Jason-sketch729/OpenSourcePlanarCableRobot-main/CableRobotFinalVersion.jpg

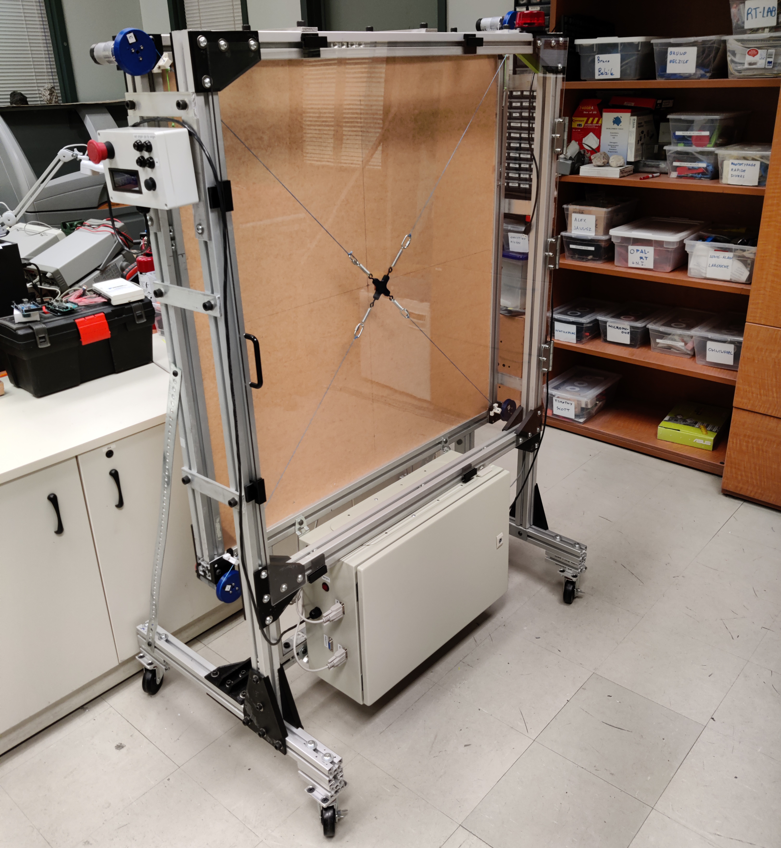
CableRobotFinalVersion.jpg
