Jason-sketch729/OpenSourcePlanarCableRobot-main/BOM.xlsx

PLANAR CDPR BILL OF MATERIALS
Designation | Manufacturer / Supplier | QTY | Unit | Unit Price | Total | Link / Comment
MECHANICAL STRUCTURE
Aluminum extrusions 45mm | Bosh-Rexroth | 14.1 | m | $35.36 | $498.55 | https://store.boschrexroth.com/Assembly-Technology/Basic-mechanic-elements/Profiles-and-accessories/Strut-profile/STRUT-PROFILE_3842553621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
Aluminum bars 3/8" x 1.5" | Hardware store | 1.6 | m | $26.00 | $41.60 | N/A
ABS for 3D printed parts | Amazon | 3.6 | kg | $22.87 | $82.35 | https://www.amazon.ca/AMZ3D-1-75mm-Black-Printer-Filament/dp/B01D999TVO
Caster wheels | Amazon | 4 |  | $6.05 | $24.19 | https://www.amazon.com/GBL-Casters-Castors-Furniture-Workbench/dp/B07KVM276F/
Polycarbonate Sheets: 1/8" (front) and 1/4" (back) thick, 1m square | Polyalto | 2 |  | $125.24 | $250.47 | https://www.polyalto.com/fr/catalogue/produits/polycarbonate-gp-tout-usage
Hinges | Amazon | 3 |  | $2.00 | $6.00 | https://www.amazon.com/Brushed-Interior-Corners-Residential-Hardware/dp/B09T3D2C62/
Springs box | Amazon | 1 |  | $12.01 | $12.01 | https://www.amazon.com/Neiko-50456A-Assortment-Compression-Extension/dp/B000K7M36W/
250lb cable | Amazon | 1 |  | $13.95 | $13.95 | https://www.amazon.com/emma-kites-Braided-Creative-Projects/dp/B01850OST0
Drop in T nuts | Aliexpress | 180 |  | $0.47 | $84.15 | https://www.aliexpress.com/item/4001249847405.html
M8 screws | Aliexpress | 180 |  | $0.31 | $55.44 | https://www.aliexpress.com/item/4000148454577.html
Door handle | Amazon | 1 |  | $6.50 | $6.50 | https://www.amazon.com/Uxcell-a11081400ux0074-Cabinet-Plastic-Rectangular/dp/B007VBT5CA/
Mini carabiner clip kit | Amazon | 1 |  | $8.99 | $8.99 | https://www.amazon.com/Stainless-Steel-Carabiner-Clip-Spring-Snap/dp/B08DTCM52N/
Eye hooks #3 kit | Aliexpress | 1 |  | $2.38 | $2.38 | https://www.aliexpress.com/item/1005002732256168.html
M3 screw kit | Amazon | 1 |  | $17.96 | $17.96 | https://www.amazon.com/VIGRUE-570PCS-Stainless-Assortment-Machine/dp/B08H24W42K/
ELECTRICAL HARDWARE
Panel mount usb connector | Amazon | 1 |  | $7.99 | $7.99 | https://www.amazon.com/ChenYang-Degree-Angled-Female-extension/dp/B00S5WJ5RO/
Electrical cabinet | Allied Electric | 1 |  | $103.46 | $103.46 | https://www.alliedelec.com/product/rs-pro-by-allied/7755328/70824480/
Electrical box (teach pendant) | Digikey | 1 |  | $7.60 | $7.60 | https://www.digikey.com/en/products/detail/bud-industries/PT-11557-G/387082
Push buttons | Digikey | 4 |  | $2.01 | $8.04 | https://www.digikey.com/en/products/detail/e-switch/PS1023ABLK/82862
Potentiometer Joystick | Digikey | 1 |  | $4.50 | $4.50 | https://www.digikey.com/en/products/detail/sparkfun-electronics/COM-09032/
680 ohm resistor | Digikey | 8 |  | $0.10 | $0.80 | https://www.digikey.com/en/products/detail/yageo/CFR-25JT-52-680R/9098651
1 kohm resistor | Digikey | 1 |  | $0.10 | $0.10 | https://www.digikey.com/en/products/detail/yageo/CFR-25JB-52-1K/96
100 nF capacitor | Digikey | 8 |  | $0.33 | $2.64 | https://www.digikey.com/en/products/detail/kemet/C320C104K3R5TA/12701287
22mF 25V capacitor | Digikey | 1 |  | $4.87 | $4.87 | https://www.digikey.com/en/products/detail/nichicon/LLS1E223MELB
LCD screen | Adafruit | 1 |  | $17.95 | $17.95 | https://www.adafruit.com/product/198
Barrier Blocks 2 positions | Digikey | 4 |  | $2.59 | $10.36 | https://www.digikey.com/en/products/detail/te-connectivity-amp-connectors/1546477-2/2284035
Barrier Blocks 4 positions | Digikey | 2 |  | $2.94 | $5.88 | https://www.digikey.com/en/products/detail/te-connectivity-amp-connectors/1546306-4/1277415
General purpose prototype boards | Digikey | 5 |  | $1.59 | $7.95 | https://www.digikey.com/en/products/detail/chip-quik-inc/SBBTH1508-1/5978279
Crimp Connectors | Amazon | 1 |  | $39.99 | $39.99 | https://www.amazon.com/haisstronica-Crimping-Connectors-HS-8327-Electrical/dp/B099W4FVRB/
Straight pin header (0.1" pitch) | Robotshop | 5 |  | $1.61 | $8.05 | https://www.robotshop.com/products/sfe-straight-pin-headers
Power entry module (IEC 320) | Digikey | 1 |  | $1.20 | $1.20 | https://www.digikey.com/en/products/detail/adam-tech/IEC-C-1-150/9830624
DB9 2m cable | Digikey | 4 |  | $5.20 | $20.80 | https://www.digikey.com/en/products/detail/cinch-connectivity-solutions/30-9506-99/3830292
DB-9 female connector | Digikey | 4 |  | $0.70 | $2.80 | https://www.digikey.com/en/products/detail/amphenol-cs-fci/DE09S064TLF/1001839
DB-9 male connector | Digikey | 4 |  | $0.72 | $2.88 | https://www.digikey.com/en/products/detail/amphenol-cs-fci/DE09P064TXLF/1001838
DB-15 | Digikey | 1 |  | $0.75 | $0.75 | https://www.digikey.com/en/products/detail/adam-tech/DA15-PR/9832244
D-sub backshells | Digikey | 4 |  | $0.78 | $3.12 | https://www.digikey.com/en/products/detail/assmann-wsw-components/AGP-09-G/1241839
Power switch on off with light | Digikey | 1 |  | $9.59 | $9.59 | https://www.digikey.com/en/products/detail/bulgin/H8553VBBA3-551W/2747894
Red Led | Digikey | 5 |  | $0.17 | $0.85 | https://www.digikey.com/en/products/detail/creeled-inc/C5SMF-RJF-CT0W0BB1/
CR2032 battery | Digikey | 1 |  | $0.48 | $0.48 | https://www.digikey.com/en/products/detail/murata-electronics/CR2032/9558425
12V Strobe Light | Amazon | 1 |  | $20.49 | $20.49 | https://www.amazon.com/12V-24V-Flashing-Magnetic-Straight-Forklift/dp/B07KF4HJ83/
Emergency Switch | Digikey | 1 |  | $57.77 | $57.77 | https://www.digikey.com/en/products/detail/omron-automation-and-safety/A22E-M-01/456041
Panduct wire duct | Allied Electric | 6 |  | $6.88 | $41.28 | https://www.alliedelec.com/product/panduit/f1x2lg6/70333454/
Power cord | Amazon | 1 |  | $6.75 | $6.75 | https://www.amazon.com/dp/B072BYGKZZ/
Nylon spacer kit | Amazon | 1 |  | $9.99 | $9.99 | https://www.amazon.com/Electrical-Spacers-Assortment-Threaded-Receptacle/dp/B0BKFYFXWR/
PG7 Cable Gland (10pcs) | Aliexpress | 1 |  | $1.17 | $1.17 | https://www.aliexpress.com/item/4000242432947.html
AWG 22 electrical wire (control signals) | Amazon | 1 |  | $16.98 | $16.98 | https://www.amazon.com/Silicone-Electrical-Conductor-Parallel-Flexible/dp/B07K9R9LBV/
AWG 18 electrical wire (motors) | Amazon | 1 |  | $12.98 | $12.98 | https://www.amazon.com/Silicone-Electrical-Conductor-Parallel-Flexible/dp/B07K9R9LBV/
MECHATRONIC ELEMENTS
DC Gearmotor 37Dx73L | Pololu | 4 |  | $51.95 | $207.80 | https://www.pololu.com/product/4755
L-Brackets | Pololu | 2 |  | $9.95 | $19.90 | https://www.pololu.com/product/1084
Universal Hubs | Pololu | 2 |  | $9.95 | $19.90 | https://www.pololu.com/product/1083
Current sensors ACS711EX | Pololu | 4 |  | $3.95 | $15.80 | https://www.pololu.com/product/2452
12V power supply | Digikey | 1 |  | $41.27 | $41.27 | https://www.digikey.com/en/products/detail/mean-well-usa-inc/LRS-350-12/7705030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
Roboclaw solo 30A | BasicMicro | 4 |  | $89.95 | $359.80 | https://www.basicmicro.com/Roboclaw-Solo-30A-34VDC-Motor-Controller_p_44.html
Arduino Mega | Robotshop | 1 |  | $48.40 | $48.40 | https://www.robotshop.com/products/arduino-mega-2560-microcontroller-rev3
Arduino pro mini | Robotshop | 1 |  | $10.95 | $10.95 | https://www.robotshop.com/products/arduino-pro-mini-328-5v-16mhz
VINT Hub (optional) | Phidgets | 1 |  | $30.00 | $30.00 | https://www.phidgets.com/?tier=3&catid=2&pcid=1&prodid=1202
MISC
Labels for the wiring | Amazon | 1 |  | $7.59 | $7.59 | https://www.amazon.com/Mr-Label-Inkjet-Printer-Support-Waterproof/dp/B01HB59G7O/
GRAND TOTAL |  |  |  |  | $2306.01
 |  |  |  |  | All prices exclude VAT, custom duties, and shipping
TOOL LIST
Screwdrivers
Drill with various size meshes
Soldering iron and tin
Miter saw (capable of aluminium cutting)
Allen keys
Electric tape
Heat shrink tubing
Crimping tool (if suggested connector kit not purchased)
Multimeter (optional, debugging)
Oscilloscope (optional, debugging)
Label maker (optional but strongly recommended)
AUTHORS
by Mikael Arslan and Lionel Birglen
Polytechnique Montreal
created: 2023-02-17
last update: 2023-06-22
Rev 1.02
