Jason-sketch729/OpenSourcePlanarCableRobot-main/CAD/SpiralPulley/Assembly.SLDASM

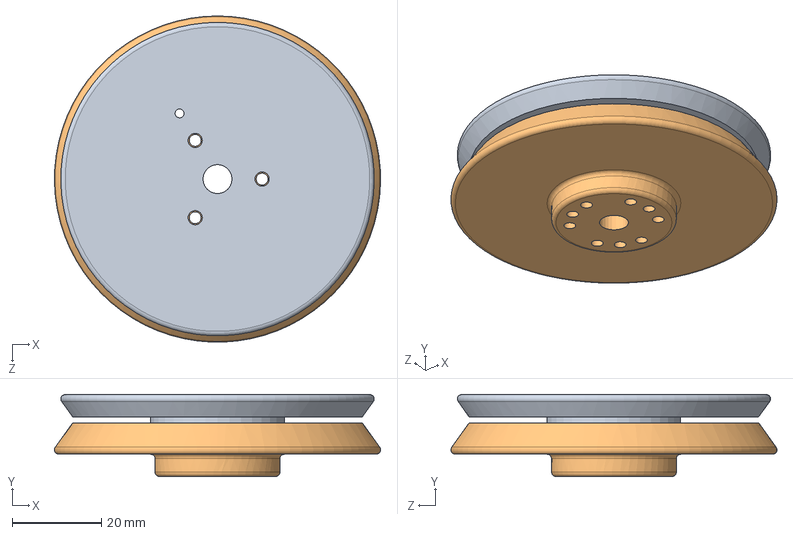
[picture p2: CAD file, 2019-04-16]
CAD/SpiralPulley/Assembly.SLDASM
73.1 x 18.4 x 73.1 mm
partB
partA
