Jason-sketch729/OpenSourcePlanarCableRobot-main/CAD/RobotMainFrame/ActuationUnit.SLDASM

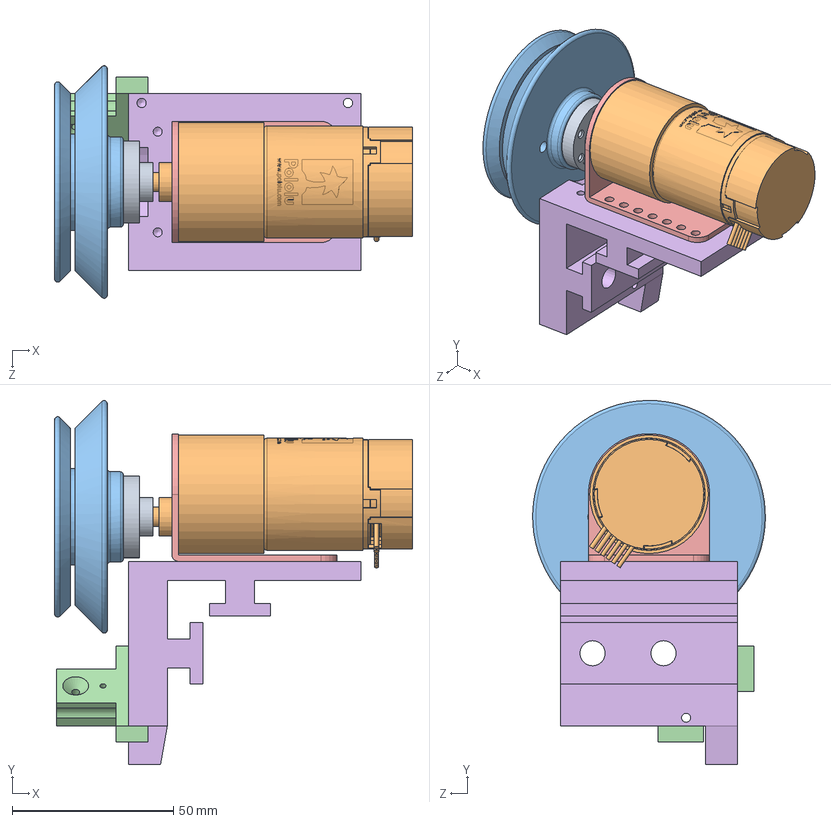
[picture p3: CAD file, 2019-04-07]
CAD/RobotMainFrame/ActuationUnit.SLDASM
111.0 x 112.9 x 72.1 mm
coupleur_poulie-moteur
moteur
poulie_originale
redirecteur
support_moteur
support_moteur_extrusion
