Jason-sketch729/OpenSourcePlanarCableRobot-main/CAD/RobotMainFrame/CableRobotMainFrame.SLDASM

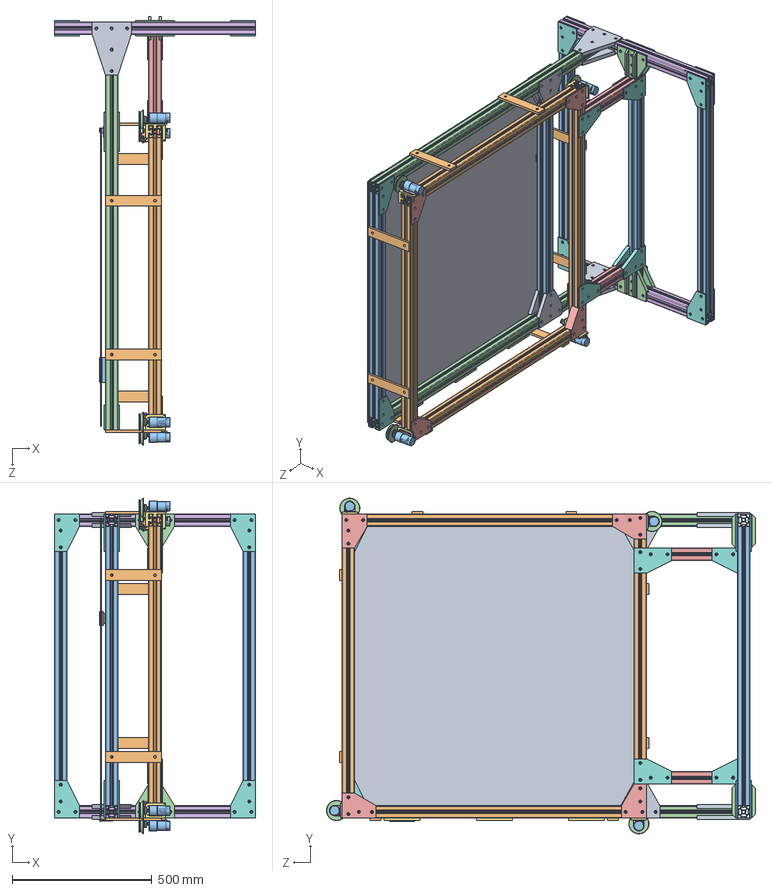
[picture p4: CAD file, 2019-04-07]
CAD/RobotMainFrame/CableRobotMainFrame.SLDASM
720.0 x 1201.8 x 1535.9 mm
extrusion_alu_45_1045 x 4
extrusion_alu_45_1000 x 5
extrusion_alu_45_1415 x 2
extrusion_alu_45_325 x 2
extrusion_alu_45_720 x 2
cale_charnière x 3
equerre_L_support_angle x 10
equerre_T_support_inferieur x 4
plexi-protection
coupleur_poulie-moteur x 4
moteur x 4
poulie_originale x 4
redirecteur x 4
support_moteur x 4
support_moteur_extrusion x 4
equerre_L_support_angle_sym x 10
equerre_T_support_milieu x 4
barre_alu x 8
demi_charnière_porte_3.5in x 2
equerre_T_support_base x 4
equerre_L_support_angle_arriere x 4
support_aimant_plexi
support aimant cadre
