Jason-sketch729/OpenSourcePlanarCableRobot-main/CAD/ElectricalCabinet/3DPrintedParts/standoff.STL

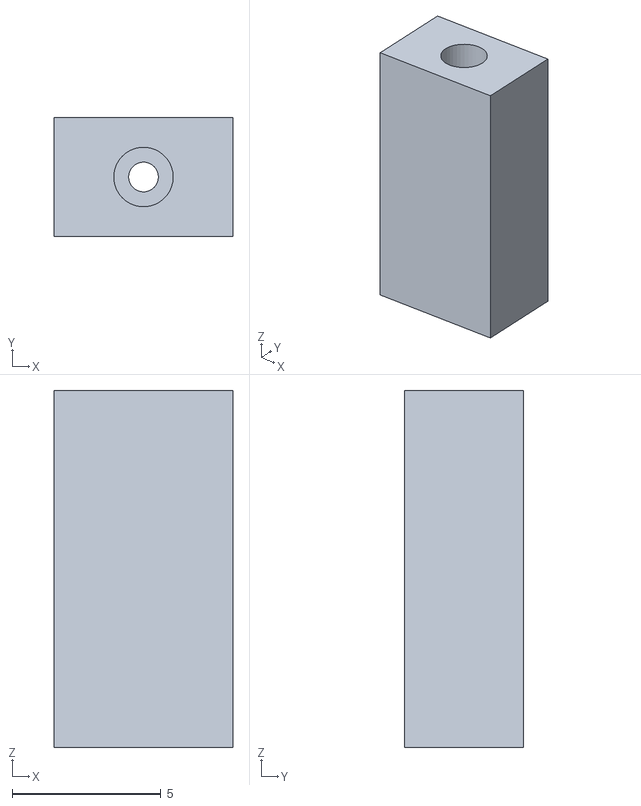
[picture p5: CAD file, 2019-04-02]
CAD/ElectricalCabinet/3DPrintedParts/standoff.STL
6.00 x 4.00 x 12.0
