Jason-sketch729/OpenSourcePlanarCableRobot-main/CAD/ElectricalCabinet/round_switch.SLDPRT

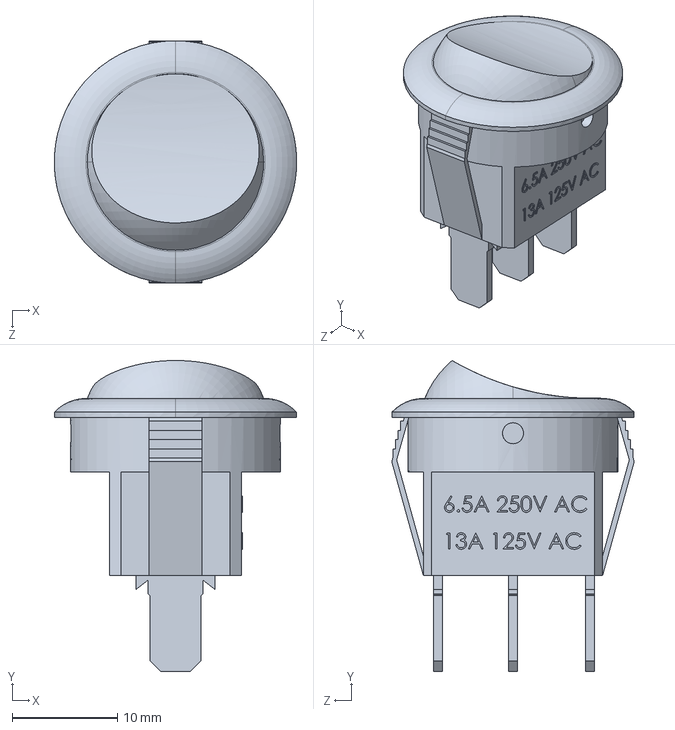
[picture p6: CAD file, 2019-04-03]
CAD/ElectricalCabinet/round_switch.SLDPRT
23.0 x 29.5 x 23.0 mm
