Jason-sketch729/OpenSourcePlanarCableRobot-main/CAD/RobotMainFrame/3DPrintedParts/support aimant cadre_0.STL

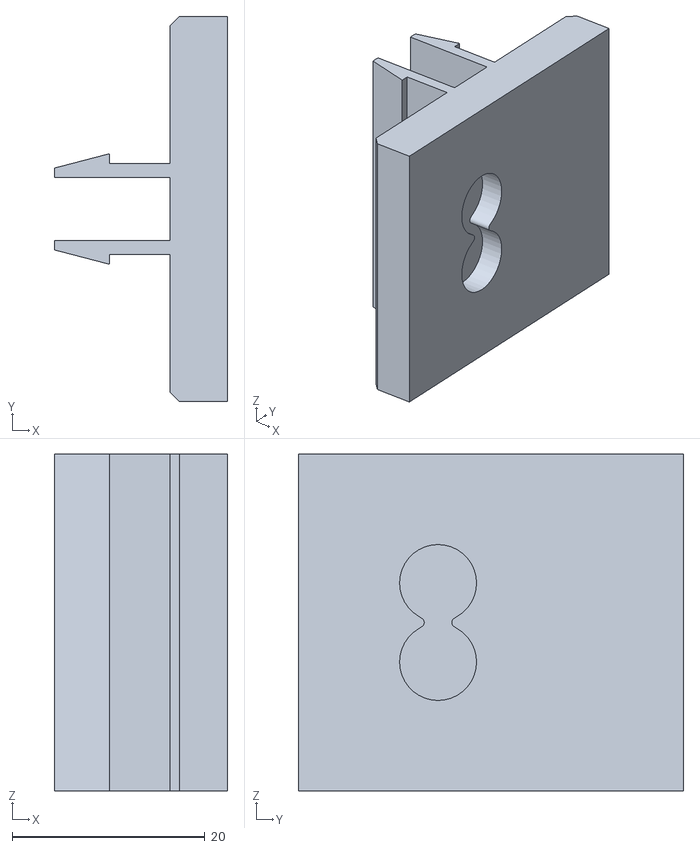
[picture p7: CAD file, 2019-04-07]
CAD/RobotMainFrame/3DPrintedParts/support aimant cadre_0.STL
18.0 x 40.0 x 35.0
