Jason-sketch729/OpenSourcePlanarCableRobot-main/CAD/RobotMainFrame/extrusions/extrusion_alu_45_720.SLDPRT

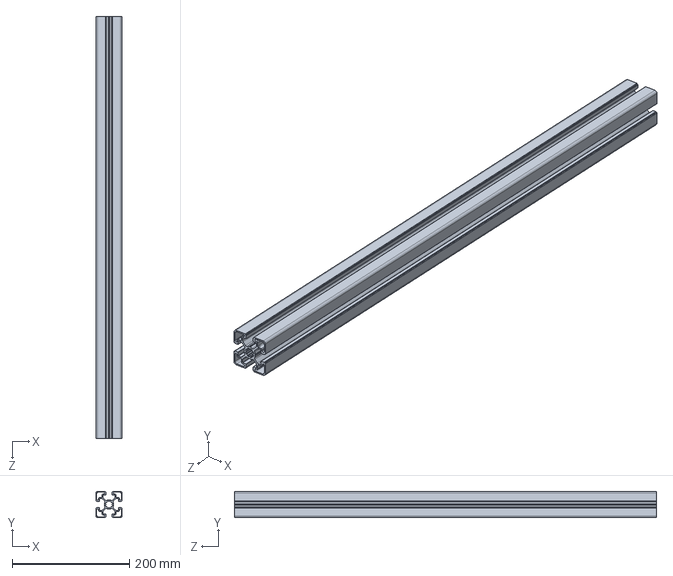
[picture p8: CAD file, 2019-04-08]
CAD/RobotMainFrame/extrusions/extrusion_alu_45_720.SLDPRT
45.0 x 45.0 x 720.0 mm
