Jason-sketch729/OpenSourcePlanarCableRobot-main/CAD/RobotMainFrame/pieces_bloc_moteur/support_moteur.SLDPRT

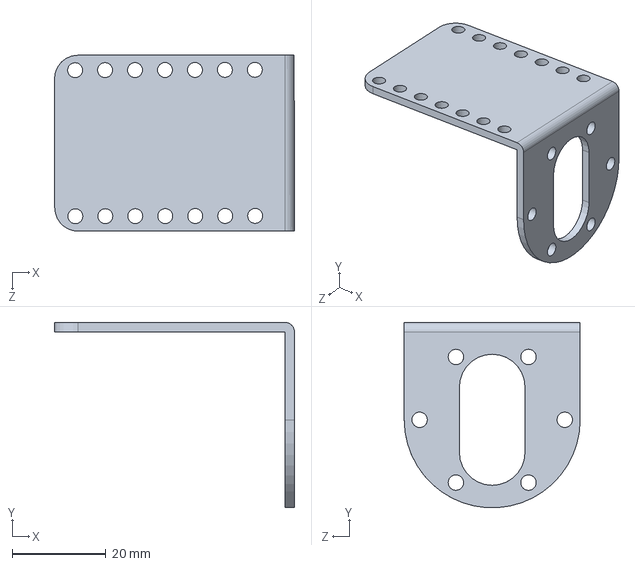
[picture p9: CAD file, 2019-04-08]
CAD/RobotMainFrame/pieces_bloc_moteur/support_moteur.SLDPRT
51.3 x 39.6 x 37.7 mm
