Jason-sketch729/OpenSourcePlanarCableRobot-main/CAD/RobotMainFrame/pieces_imprimes/cale_charnière.SLDPRT

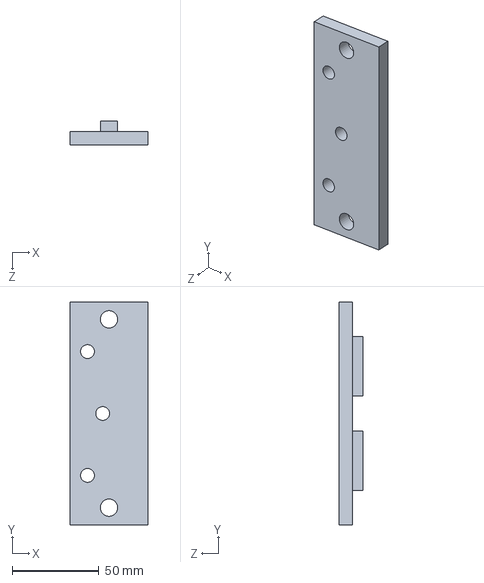
[picture p10: CAD file, 2019-04-15]
CAD/RobotMainFrame/pieces_imprimes/cale_charnière.SLDPRT
45.0 x 128.6 x 14.0 mm
