Jason-sketch729/OpenSourcePlanarCableRobot-main/CAD/RobotMainFrame/plexi-protection.SLDPRT

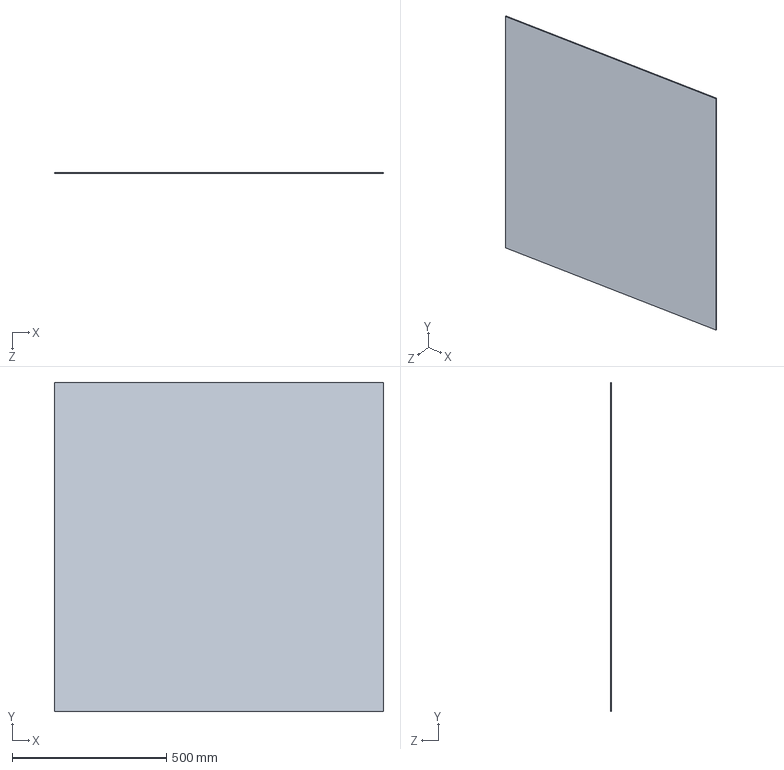
[picture p11: CAD file, 2019-04-16]
CAD/RobotMainFrame/plexi-protection.SLDPRT
1066.8 x 1066.8 x 4.76 mm
