Jason-sketch729/OpenSourcePlanarCableRobot-main/CAD/SpiralPulley/3DPrintedParts/partB.STL

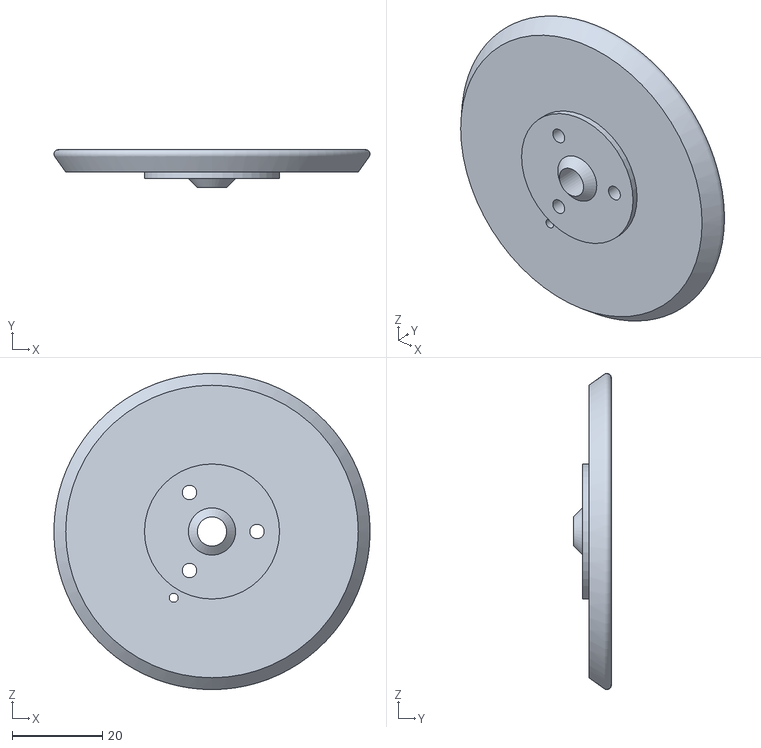
[picture p12: CAD file, 2019-04-16]
CAD/SpiralPulley/3DPrintedParts/partB.STL
70.2 x 8.40 x 70.3
