Jason-sketch729/OpenSourcePlanarCableRobot-main/RobotcableComplet.stp

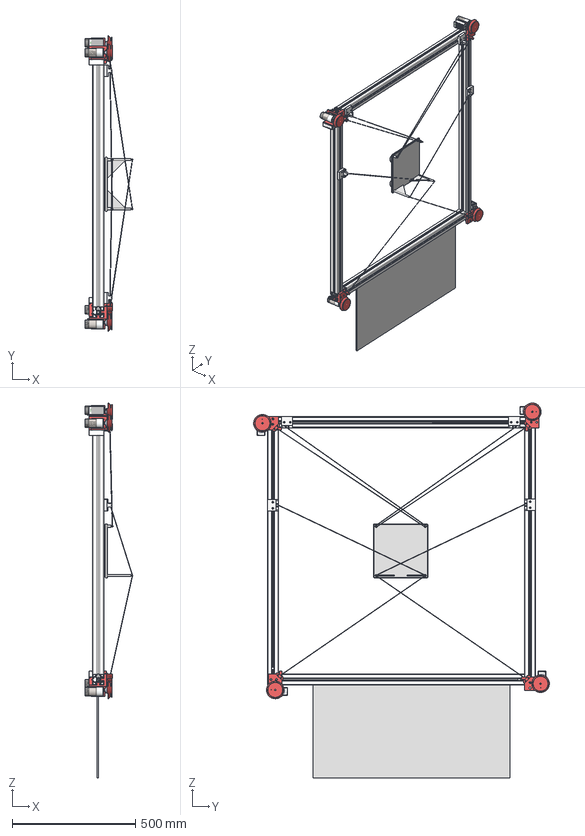
[picture p13: CAD file, 2019-04-22]
RobotcableComplet.stp
194.6 x 1201.7 x 1523.3 mm
Ross_Frame extrusion x 4
AttachmentModule x 4
Loop x 4
PF_Base
9496T350_ROUTING EYEBOLT FOR WOOD - NOT FOR LIFTING x 4
5674K100_FLANGE-MOUNT BALL TRANSFER x 4
37d-gearmotor-100-131-encoder x 4
pololu-universal-aluminum-mounting-hub-for-6mm-shaft-4-40-holes x 4
BracketPololu x 4
NewSpool x 4
MotorAttachmentV2_Pololu x 4
SupportRoboclaw x 4
MCSOLO_V2 x 4
NewRedirecteur x 4
SupportPlate
