Jason-sketch729/OpenSourcePlanarCableRobot-main/CAD/ElectricalCabinet/wire_duct_250.SLDPRT

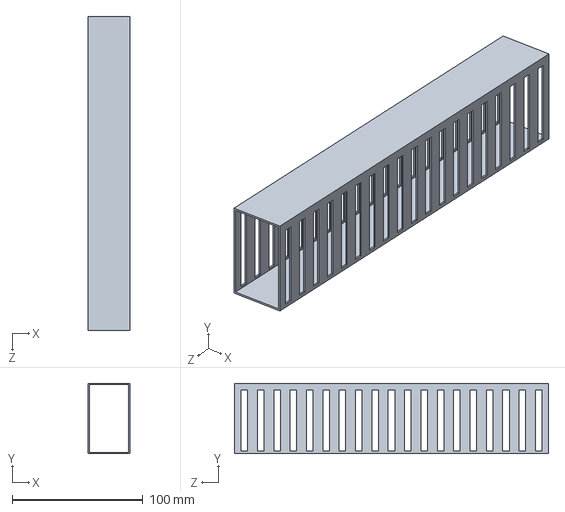
[picture p14: CAD file, 2019-04-03]
CAD/ElectricalCabinet/wire_duct_250.SLDPRT
32.0 x 53.8 x 240.0 mm
