Jason-sketch729/OpenSourcePlanarCableRobot-main/CAD/RobotMainFrame/3DPrintedParts/support_led_1.STL

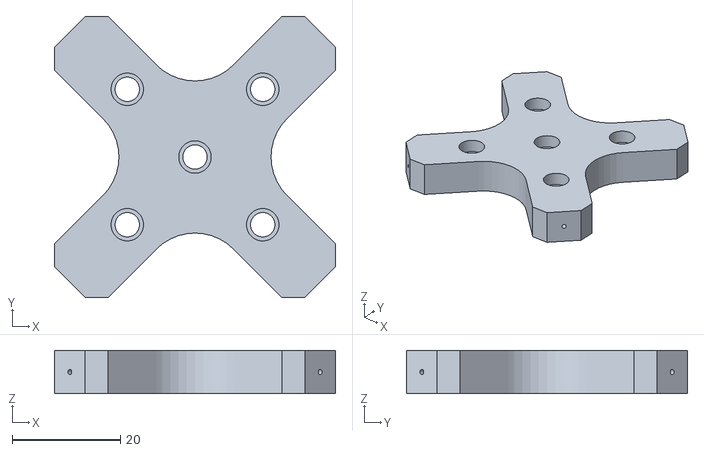
[picture p15: CAD file, 2019-04-07]
CAD/RobotMainFrame/3DPrintedParts/support_led_1.STL
51.9 x 51.9 x 8.00
