Jason-sketch729/OpenSourcePlanarCableRobot-main/CAD/RobotMainFrame/demi_charnière_porte_3.5in.SLDPRT

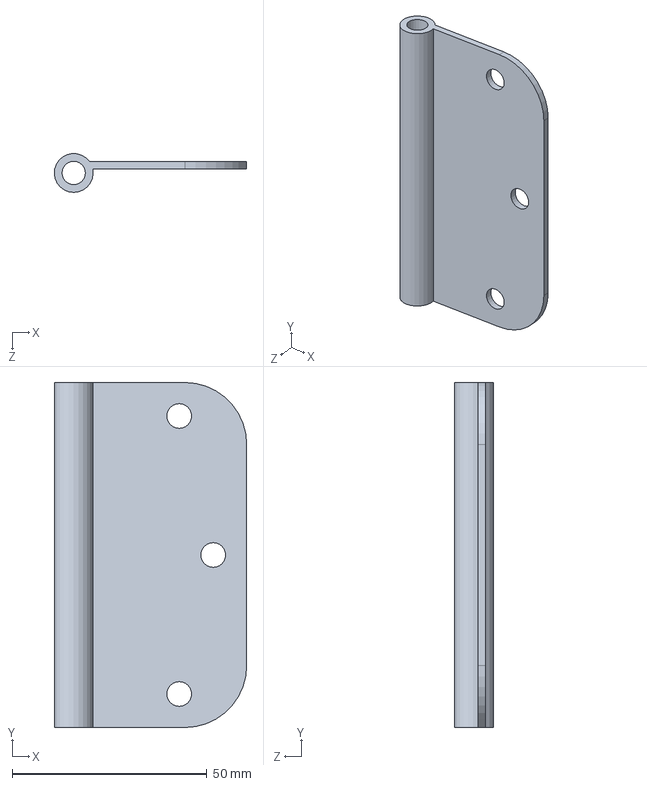
[picture p16: CAD file, 2019-04-07]
CAD/RobotMainFrame/demi_charnière_porte_3.5in.SLDPRT
49.4 x 88.6 x 9.98 mm
