Jason-sketch729/OpenSourcePlanarCableRobot-main/CAD/RobotMainFrame/extrusions/extrusion_alu_45_1415.SLDPRT

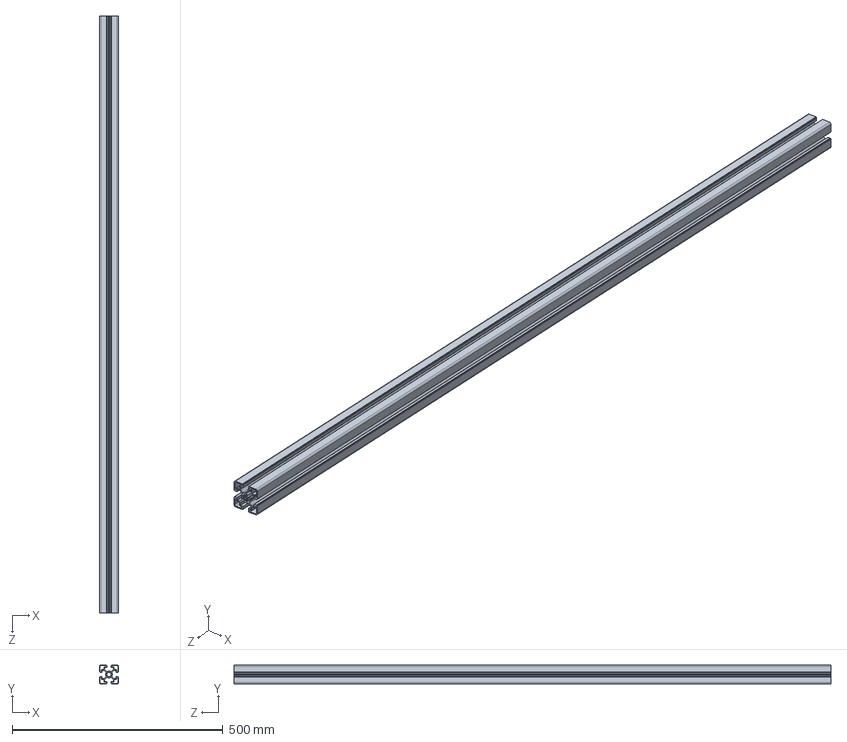
[picture p17: CAD file, 2019-04-08]
CAD/RobotMainFrame/extrusions/extrusion_alu_45_1415.SLDPRT
45.0 x 45.0 x 1415.0 mm
