Jason-sketch729/OpenSourcePlanarCableRobot-main/CAD/RobotMainFrame/pieces_bloc_moteur/coupleur_poulie-moteur.SLDPRT

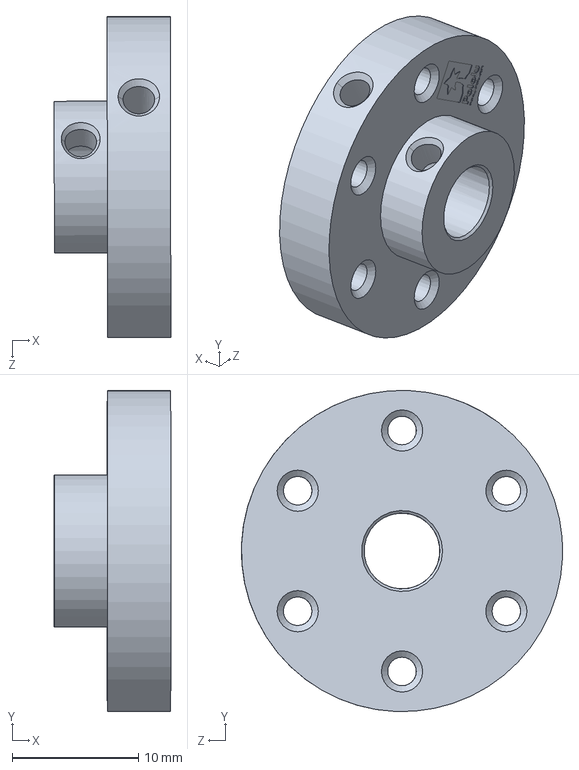
[picture p18: CAD file, 2019-04-08]
CAD/RobotMainFrame/pieces_bloc_moteur/coupleur_poulie-moteur.SLDPRT
9.24 x 25.4 x 25.4 mm
