Jason-sketch729/OpenSourcePlanarCableRobot-main/CAD/SpiralPulley/3DPrintedParts/partA.STL

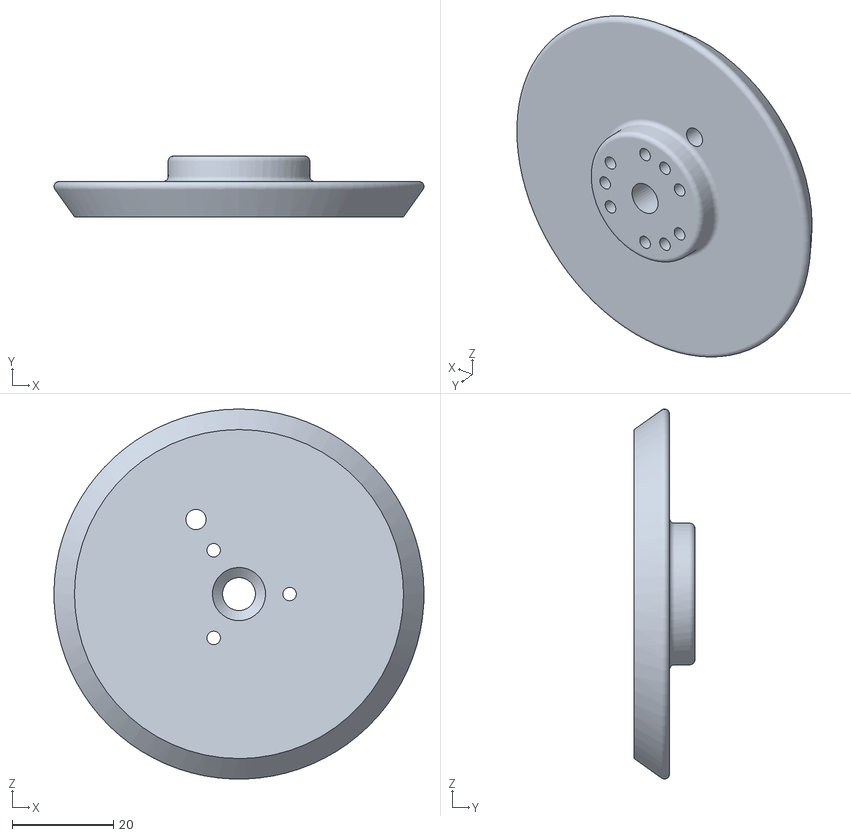
[picture p19: CAD file, 2019-04-16]
CAD/SpiralPulley/3DPrintedParts/partA.STL
73.1 x 12.0 x 73.1
