Jason-sketch729/OpenSourcePlanarCableRobot-main/CAD/ElectricalCabinet/mega_shield.SLDPRT

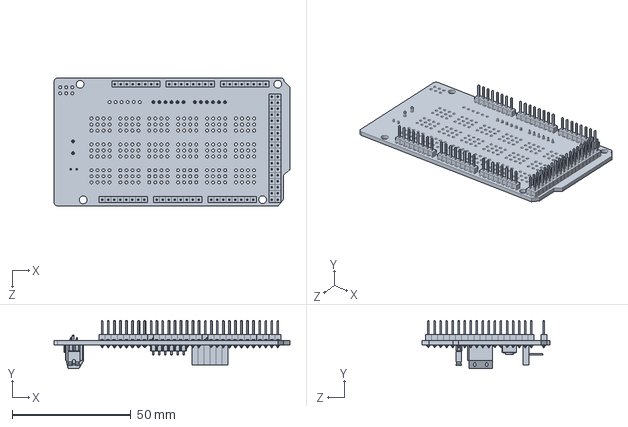
[picture p20: CAD file, 2019-04-03]
CAD/ElectricalCabinet/mega_shield.SLDPRT
99.2 x 20.3 x 53.7 mm
