Jason-sketch729/OpenSourcePlanarCableRobot-main/CAD/RobotMainFrame/3DPrintedParts/equerre_T_support_base_2.STL

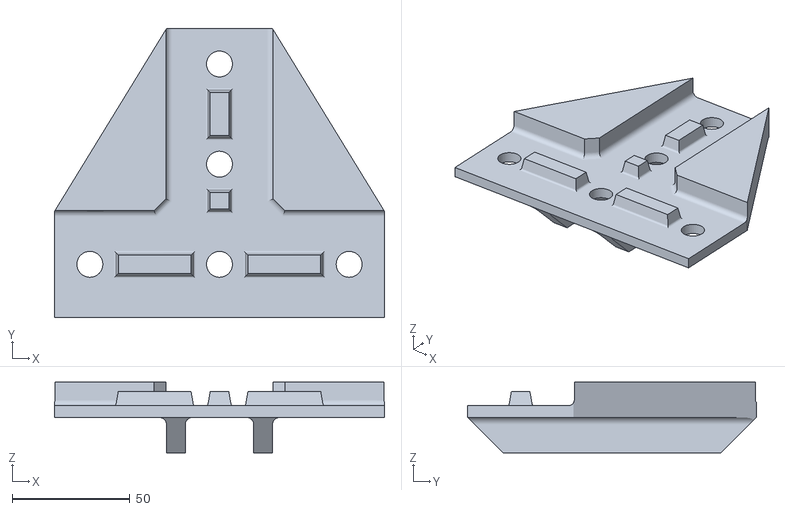
[picture p21: CAD file, 2019-04-07]
CAD/RobotMainFrame/3DPrintedParts/equerre_T_support_base_2.STL
140.0 x 122.5 x 30.0
