Jason-sketch729/OpenSourcePlanarCableRobot-main/CAD/RobotMainFrame/extrusions/extrusion_alu_45_1045.SLDPRT

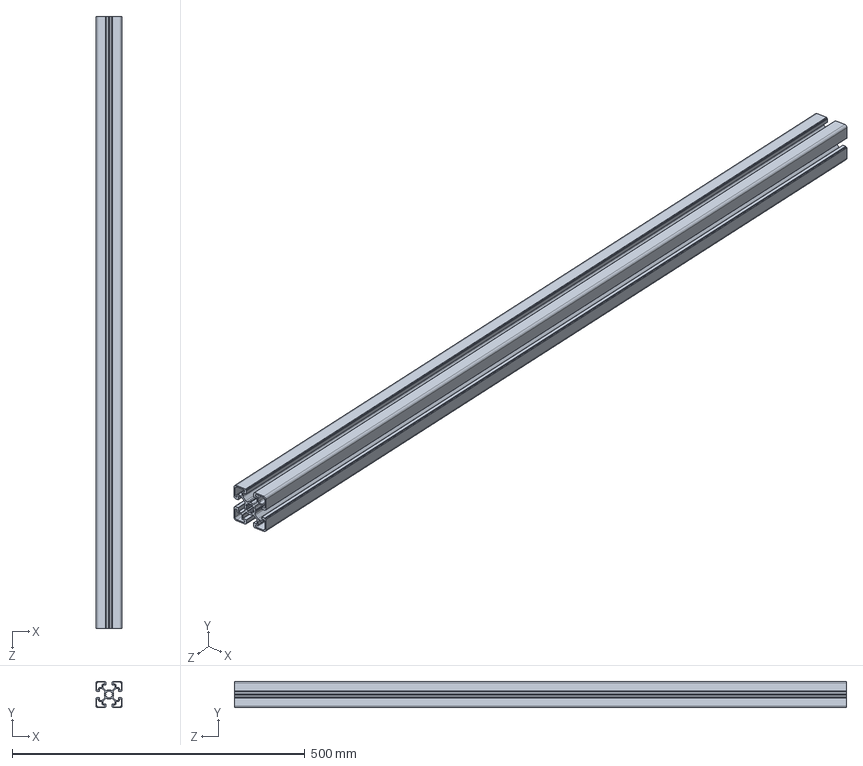
[picture p22: CAD file, 2019-04-08]
CAD/RobotMainFrame/extrusions/extrusion_alu_45_1045.SLDPRT
45.0 x 45.0 x 1045.0 mm
