Jason-sketch729/OpenSourcePlanarCableRobot-main/CAD/RobotMainFrame/pieces_bloc_moteur/support_moteur_extrusion.SLDPRT

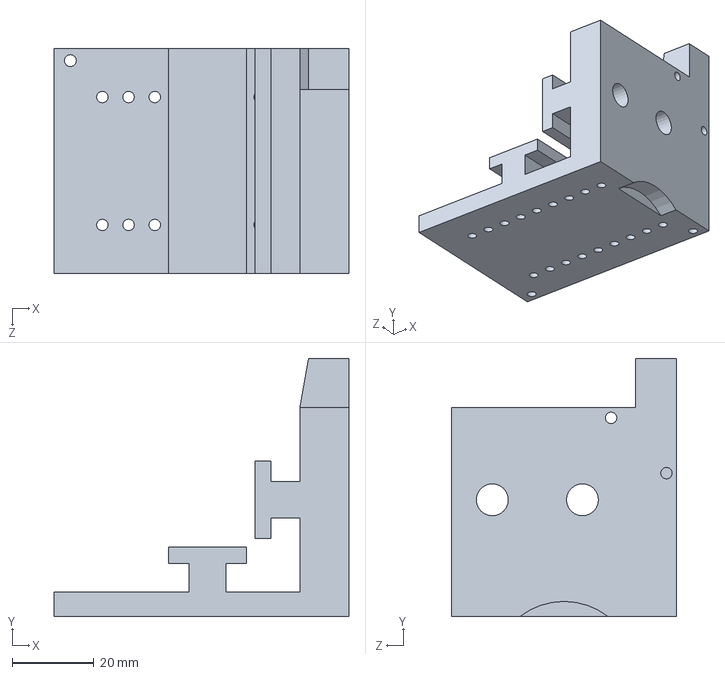
[picture p23: CAD file, 2019-04-08]
CAD/RobotMainFrame/pieces_bloc_moteur/support_moteur_extrusion.SLDPRT
72.0 x 63.0 x 55.0 mm
