Jason-sketch729/OpenSourcePlanarCableRobot-main/CAD/SpiralPulley/NewSpool2PartA.stp

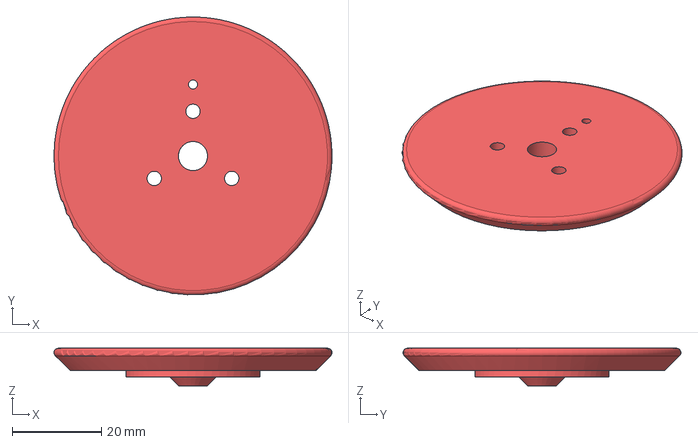
[picture p24: CAD file, 2019-04-16]
CAD/SpiralPulley/NewSpool2PartA.stp
62.2 x 62.1 x 8.40 mm
