Jason-sketch729/OpenSourcePlanarCableRobot-main/CAD/ElectricalCabinet/roboclaw.SLDPRT

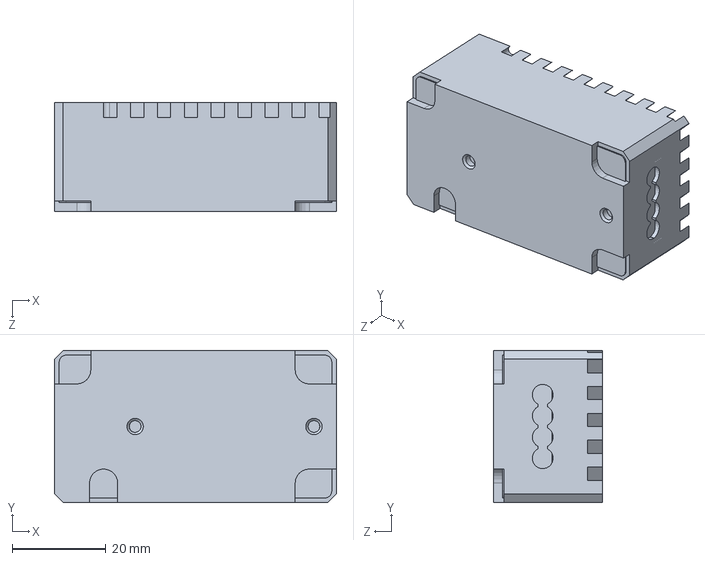
[picture p25: CAD file, 2019-04-03]
CAD/ElectricalCabinet/roboclaw.SLDPRT
60.1 x 32.4 x 23.2 mm
