Jason-sketch729/OpenSourcePlanarCableRobot-main/CAD/RobotMainFrame/3DPrintedParts/support_aimant_plexi_0.STL

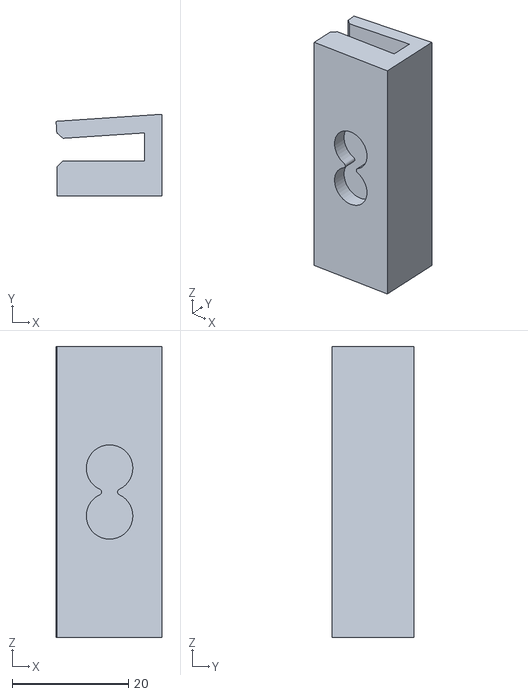
[picture p26: CAD file, 2019-04-07]
CAD/RobotMainFrame/3DPrintedParts/support_aimant_plexi_0.STL
18.2 x 14.0 x 50.0
