Jason-sketch729/OpenSourcePlanarCableRobot-main/CAD/RobotMainFrame/barre_alu.SLDPRT

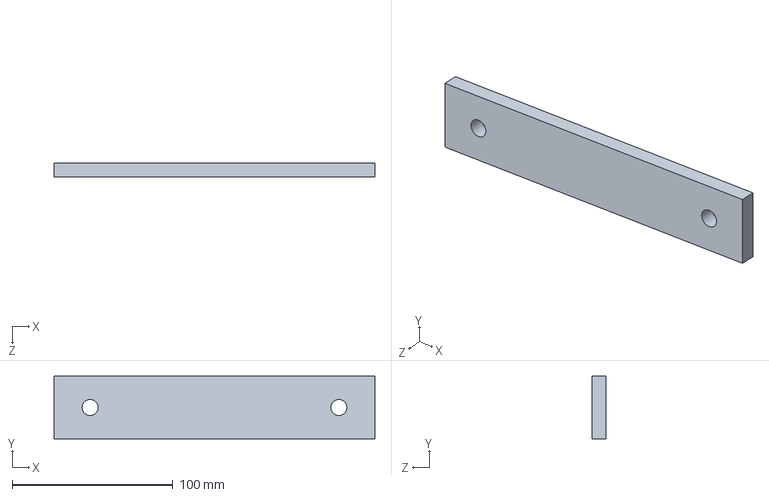
[picture p27: CAD file, 2019-04-07]
CAD/RobotMainFrame/barre_alu.SLDPRT
200.0 x 39.0 x 9.00 mm
