Jason-sketch729/OpenSourcePlanarCableRobot-main/CAD/RobotMainFrame/extrusions/extrusion_alu_45_325.SLDPRT

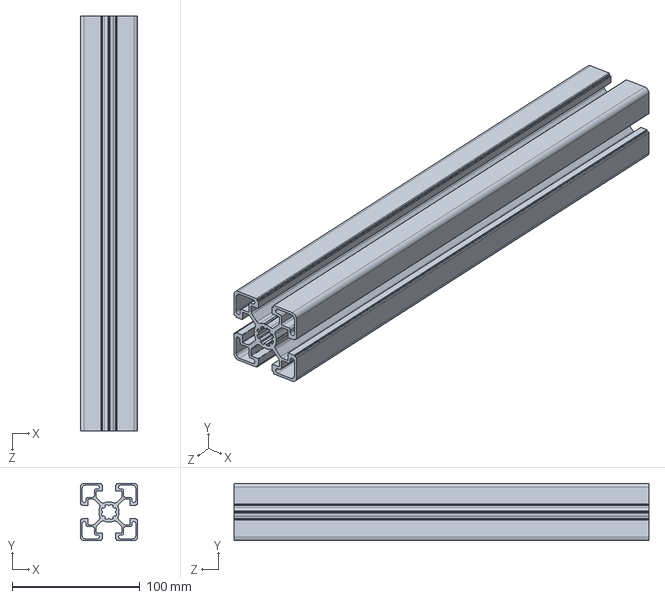
[picture p28: CAD file, 2019-04-08]
CAD/RobotMainFrame/extrusions/extrusion_alu_45_325.SLDPRT
45.0 x 45.0 x 325.0 mm
