Jason-sketch729/OpenSourcePlanarCableRobot-main/CAD/RobotMainFrame/pieces_bloc_moteur/redirecteur.SLDPRT

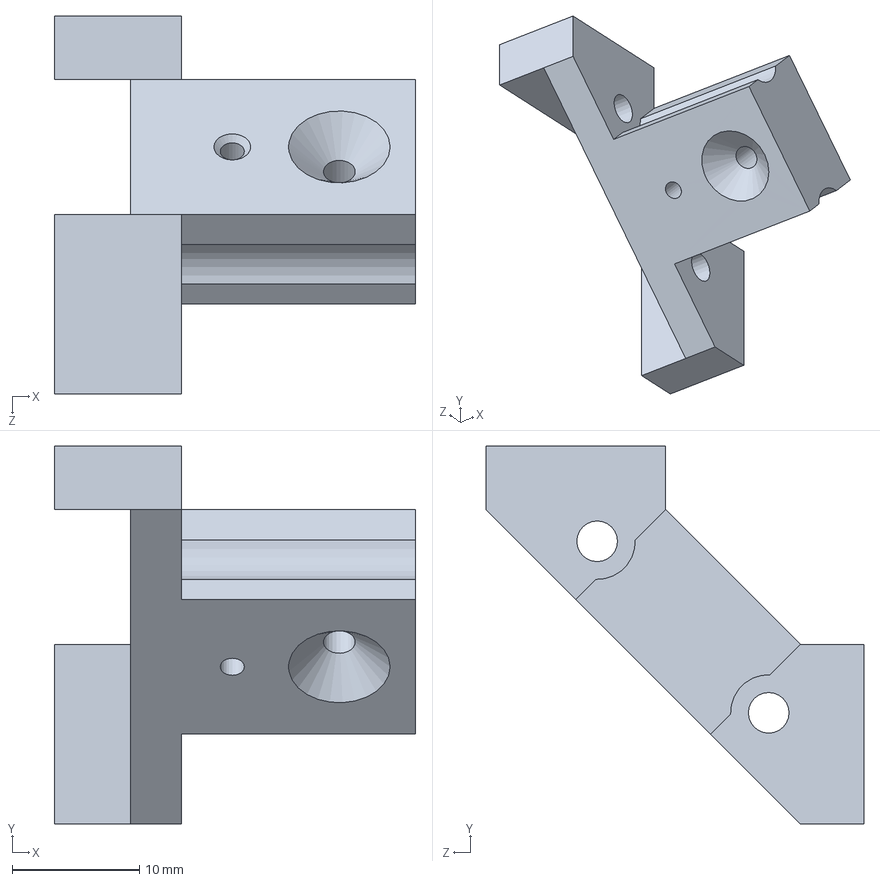
[picture p29: CAD file, 2019-04-08]
CAD/RobotMainFrame/pieces_bloc_moteur/redirecteur.SLDPRT
28.4 x 29.7 x 29.7 mm
