Jason-sketch729/OpenSourcePlanarCableRobot-main/CAD/RobotMainFrame/pieces_imprimes/fixation_plexi.SLDPRT

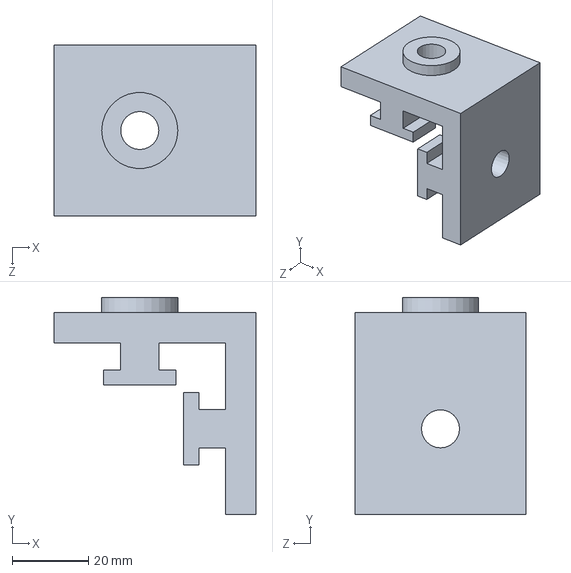
[picture p30: CAD file, 2019-04-15]
CAD/RobotMainFrame/pieces_imprimes/fixation_plexi.SLDPRT
53.0 x 57.0 x 45.0 mm
