Jason-sketch729/OpenSourcePlanarCableRobot-main/CAD/ElectricalCabinet/wire_duct_295.SLDPRT

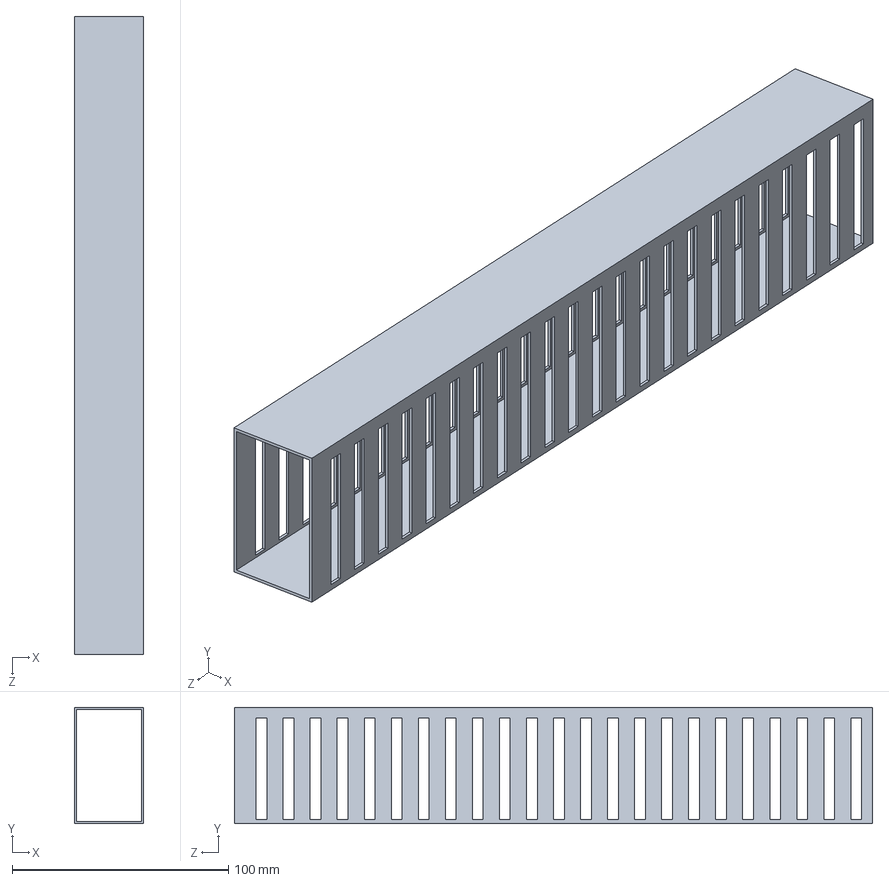
[picture p31: CAD file, 2019-04-03]
CAD/ElectricalCabinet/wire_duct_295.SLDPRT
32.0 x 53.8 x 295.0 mm
