Jason-sketch729/OpenSourcePlanarCableRobot-main/CAD/RobotMainFrame/3DPrintedParts/equerre_T_support_inferieur_4.STL

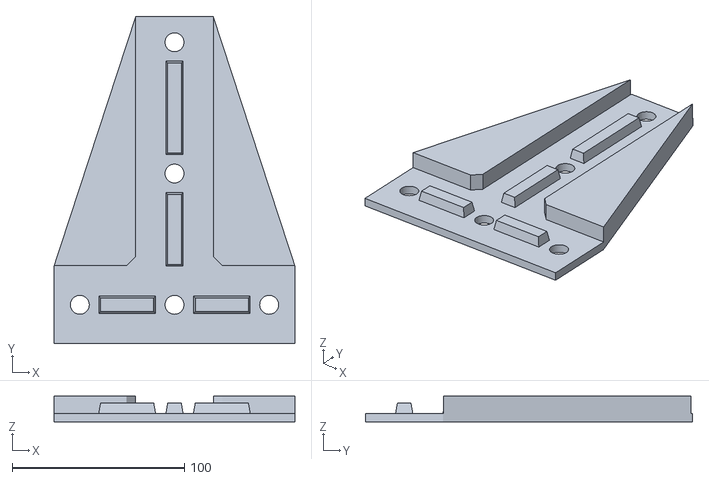
[picture p32: CAD file, 2019-04-07]
CAD/RobotMainFrame/3DPrintedParts/equerre_T_support_inferieur_4.STL
140.0 x 190.0 x 15.0
