Jason-sketch729/OpenSourcePlanarCableRobot-main/CAD/RobotMainFrame/extrusions/extrusion_alu_45_1000.SLDPRT

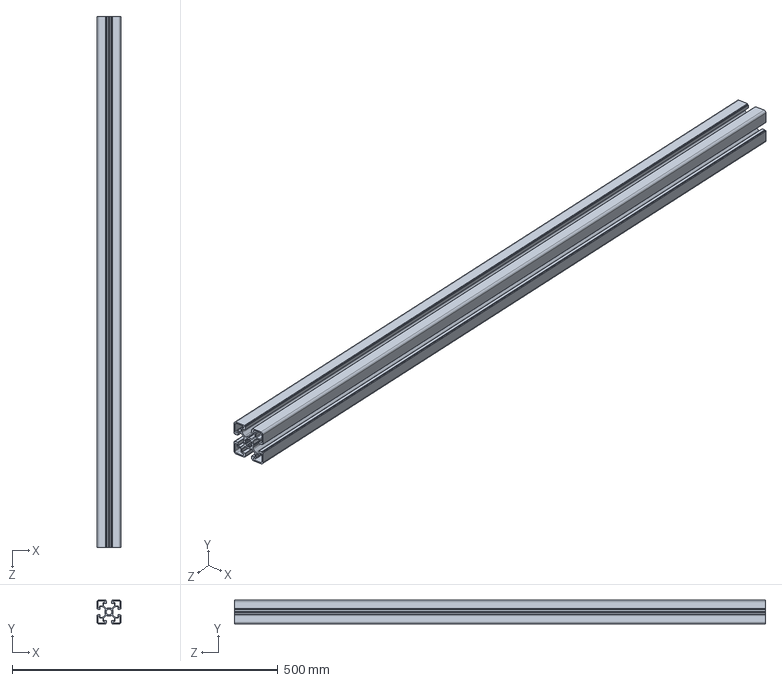
[picture p33: CAD file, 2019-04-07]
CAD/RobotMainFrame/extrusions/extrusion_alu_45_1000.SLDPRT
45.0 x 45.0 x 1000.0 mm
