Jason-sketch729/OpenSourcePlanarCableRobot-main/CAD/RobotMainFrame/pieces_bloc_moteur/poulie_originale.SLDPRT

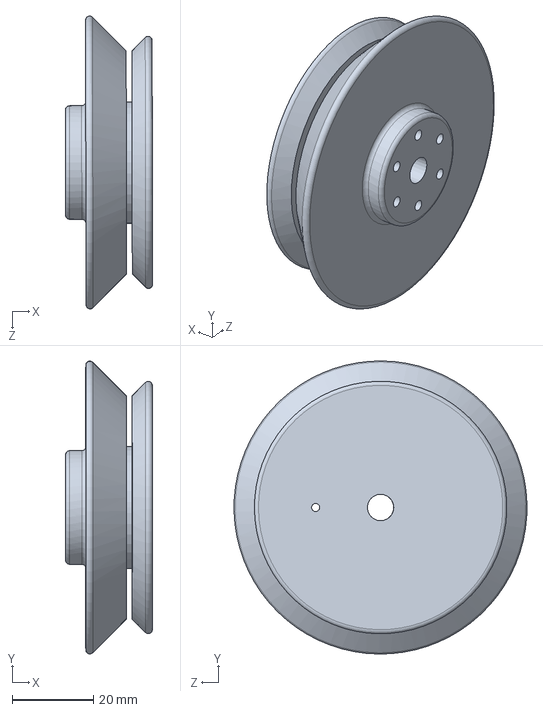
[picture p34: CAD file, 2019-04-08]
CAD/RobotMainFrame/pieces_bloc_moteur/poulie_originale.SLDPRT
21.5 x 72.2 x 72.1 mm
