Jason-sketch729/OpenSourcePlanarCableRobot-main/CAD/RobotMainFrame/pieces_imprimes/equerre_T_support_milieu.SLDPRT

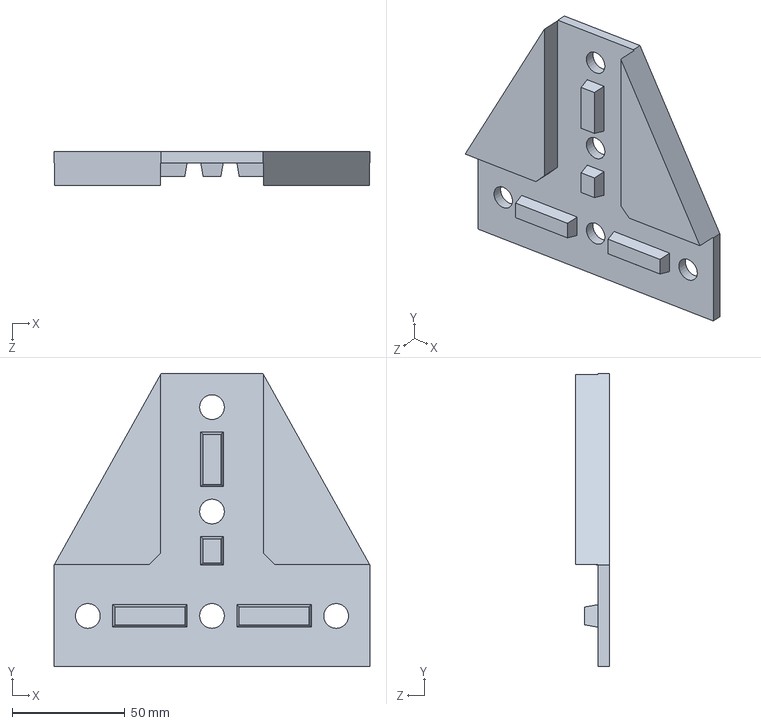
[picture p35: CAD file, 2019-04-15]
CAD/RobotMainFrame/pieces_imprimes/equerre_T_support_milieu.SLDPRT
140.0 x 130.0 x 15.0 mm
