Jason-sketch729/OpenSourcePlanarCableRobot-main/CAD/SpiralPulley/NewSpool2PartB.stp

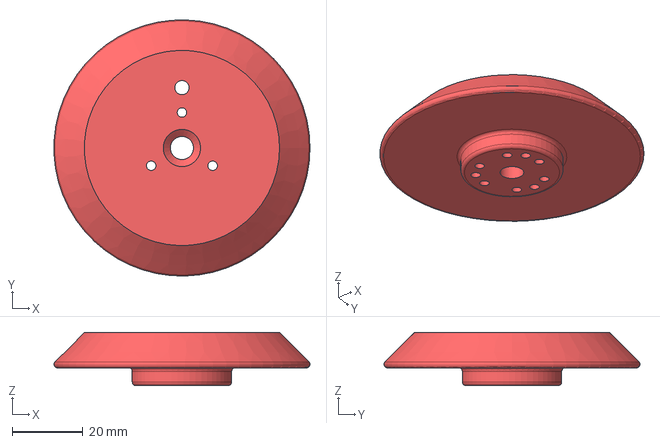
[picture p36: CAD file, 2019-04-16]
CAD/SpiralPulley/NewSpool2PartB.stp
72.1 x 72.1 x 15.0 mm
