Jason-sketch729/OpenSourcePlanarCableRobot-main/CAD/RobotMainFrame/pieces_bloc_moteur/moteur.SLDPRT

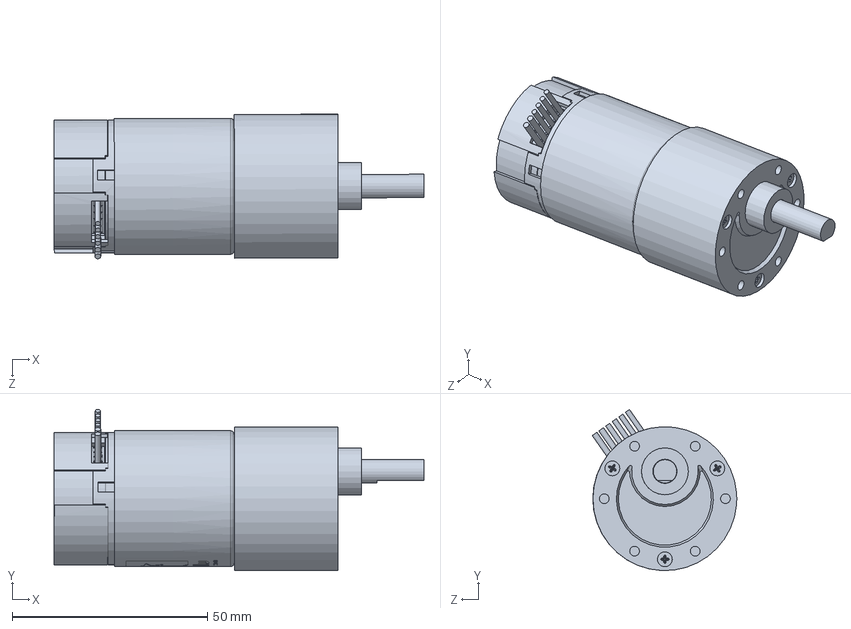
[picture p37: CAD file, 2019-04-08]
CAD/RobotMainFrame/pieces_bloc_moteur/moteur.SLDPRT
94.6 x 41.2 x 37.0 mm
