Jason-sketch729/OpenSourcePlanarCableRobot-main/CAD/RobotMainFrame/pieces_imprimes/fixation_lumière.SLDPRT

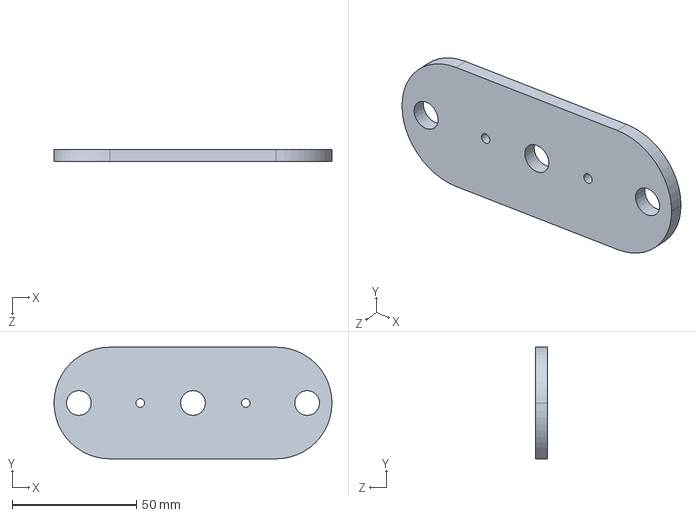
[picture p38: CAD file, 2019-04-15]
CAD/RobotMainFrame/pieces_imprimes/fixation_lumière.SLDPRT
112.0 x 45.0 x 5.00 mm
