Jason-sketch729/OpenSourcePlanarCableRobot-main/CAD/ElectricalCabinet/wire_duct_440.SLDPRT

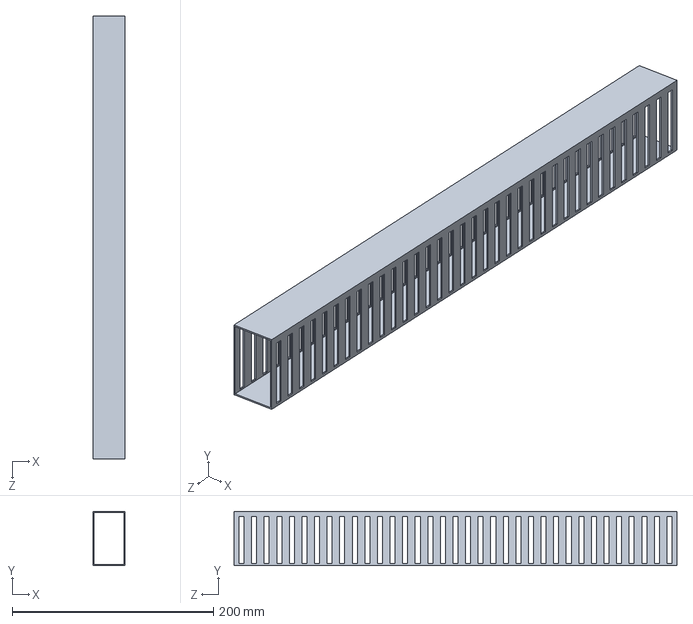
[picture p39: CAD file, 2019-04-03]
CAD/ElectricalCabinet/wire_duct_440.SLDPRT
32.0 x 53.8 x 440.0 mm
