Jason-sketch729/OpenSourcePlanarCableRobot-main/CAD/RobotMainFrame/3DPrintedParts/equerre_L_support_angle_sym_8.STL

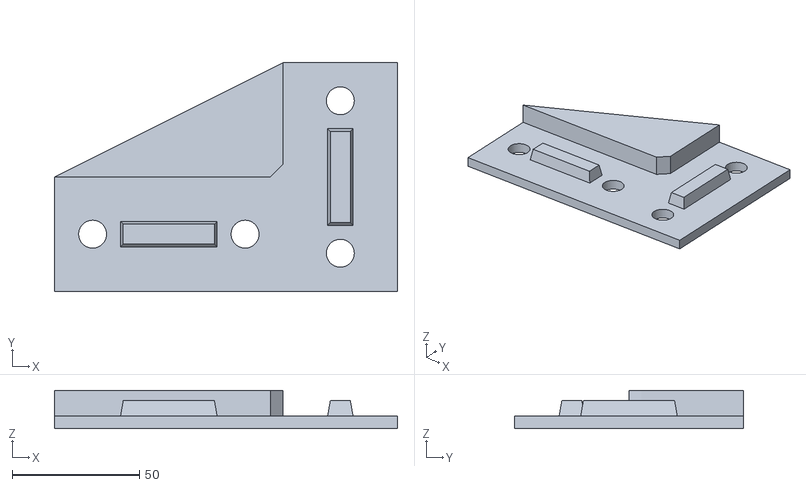
[picture p40: CAD file, 2019-04-03]
CAD/RobotMainFrame/3DPrintedParts/equerre_L_support_angle_sym_8.STL
135.0 x 90.0 x 15.0
