Jason-sketch729/OpenSourcePlanarCableRobot-main/CAD/ElectricalCabinet/DB9_pins.SLDPRT

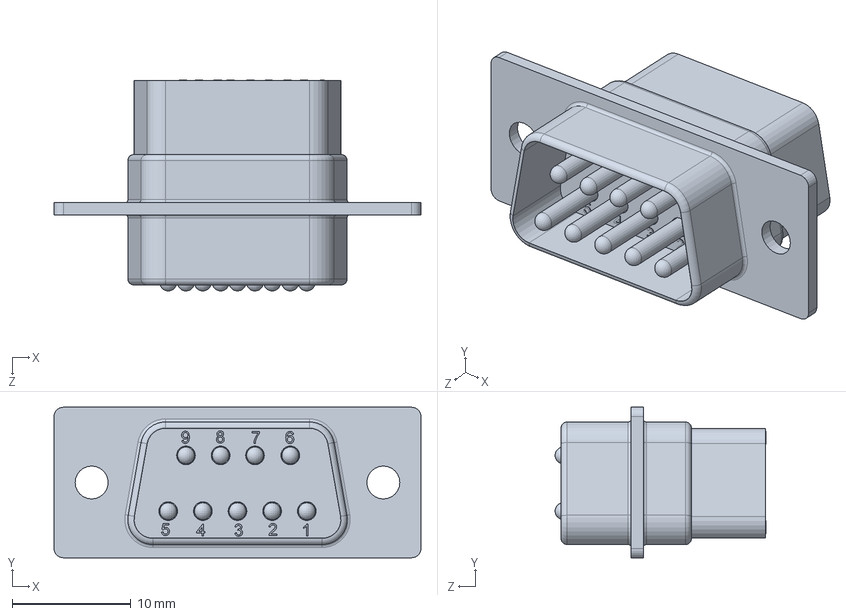
[picture p41: CAD file, 2019-04-02]
CAD/ElectricalCabinet/DB9_pins.SLDPRT
30.9 x 12.7 x 17.8 mm
