Jason-sketch729/OpenSourcePlanarCableRobot-main/CAD/RobotMainFrame/3DPrintedParts/equerre_L_support_angle_arriere_0.STL

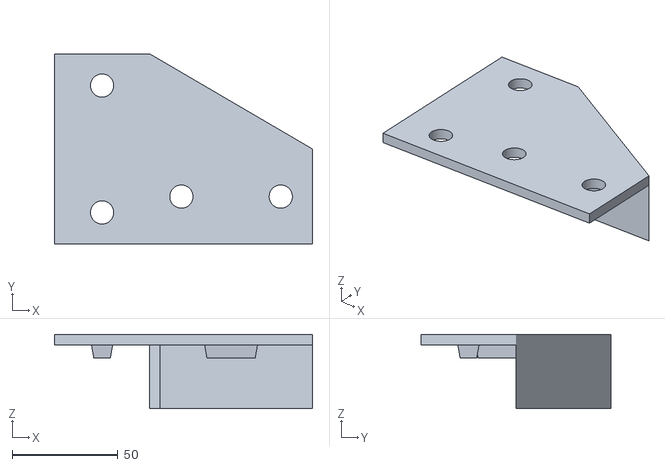
[picture p42: CAD file, 2019-04-03]
CAD/RobotMainFrame/3DPrintedParts/equerre_L_support_angle_arriere_0.STL
122.0 x 90.0 x 35.0
