Jason-sketch729/OpenSourcePlanarCableRobot-main/CAD/ElectricalCabinet/bonier_4.SLDPRT

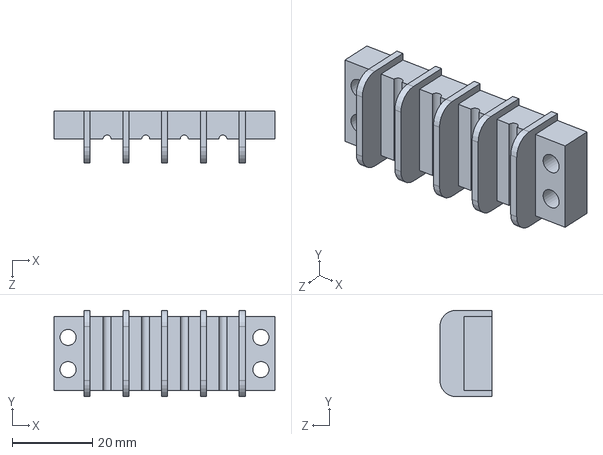
[picture p43: CAD file, 2019-04-02]
CAD/ElectricalCabinet/bonier_4.SLDPRT
55.0 x 21.5 x 13.0 mm
