Jason-sketch729/OpenSourcePlanarCableRobot-main/CAD/ElectricalCabinet/current_sensor_ACS711EX.SLDPRT

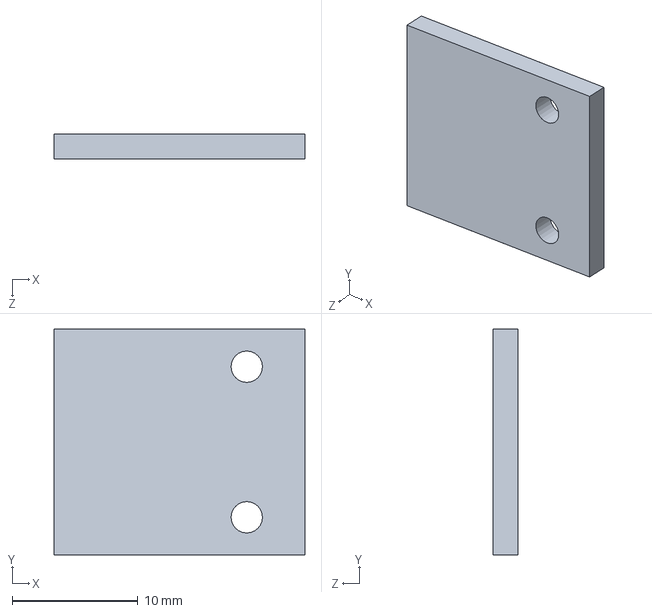
[picture p44: CAD file, 2019-04-02]
CAD/ElectricalCabinet/current_sensor_ACS711EX.SLDPRT
20.0 x 18.0 x 2.00 mm
