Jason-sketch729/OpenSourcePlanarCableRobot-main/CAD/RobotMainFrame/3DPrintedParts/Extrusion45Foot v2_4.STL

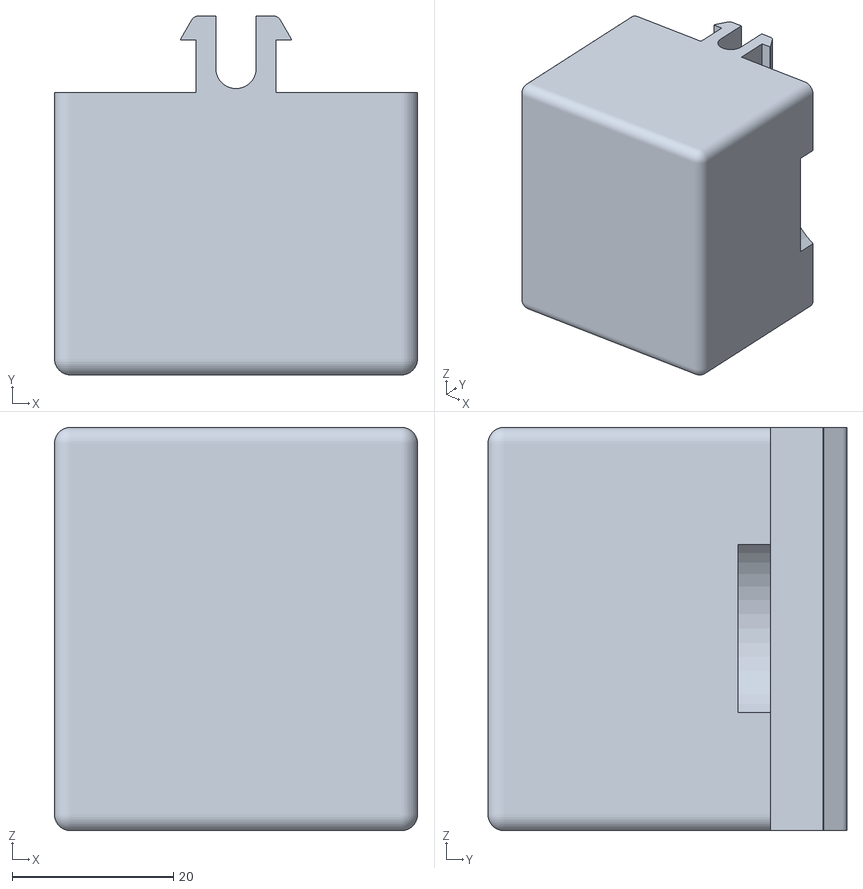
[picture p45: CAD file, 2019-04-03]
CAD/RobotMainFrame/3DPrintedParts/Extrusion45Foot v2_4.STL
45.0 x 44.5 x 50.0
