Jason-sketch729/OpenSourcePlanarCableRobot-main/CAD/ElectricalCabinet/Mean Well LRS-350 Power Supply.SLDPRT

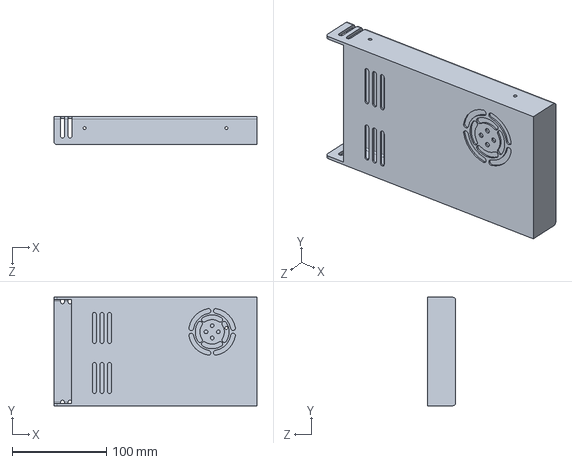
[picture p46: CAD file, 2019-04-02]
CAD/ElectricalCabinet/Mean Well LRS-350 Power Supply.SLDPRT
215.0 x 115.0 x 30.0 mm
