Jason-sketch729/OpenSourcePlanarCableRobot-main/CAD/ElectricalCabinet/bonier_6.SLDPRT

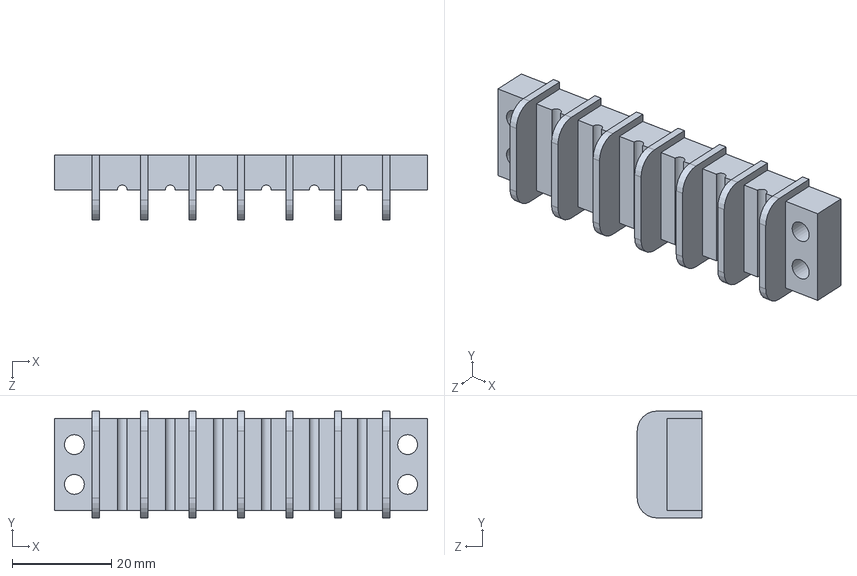
[picture p47: CAD file, 2019-04-02]
CAD/ElectricalCabinet/bonier_6.SLDPRT
75.0 x 21.5 x 13.0 mm
