Jason-sketch729/OpenSourcePlanarCableRobot-main/CAD/RobotMainFrame/pieces_imprimes/Extrusion45Foot.stp

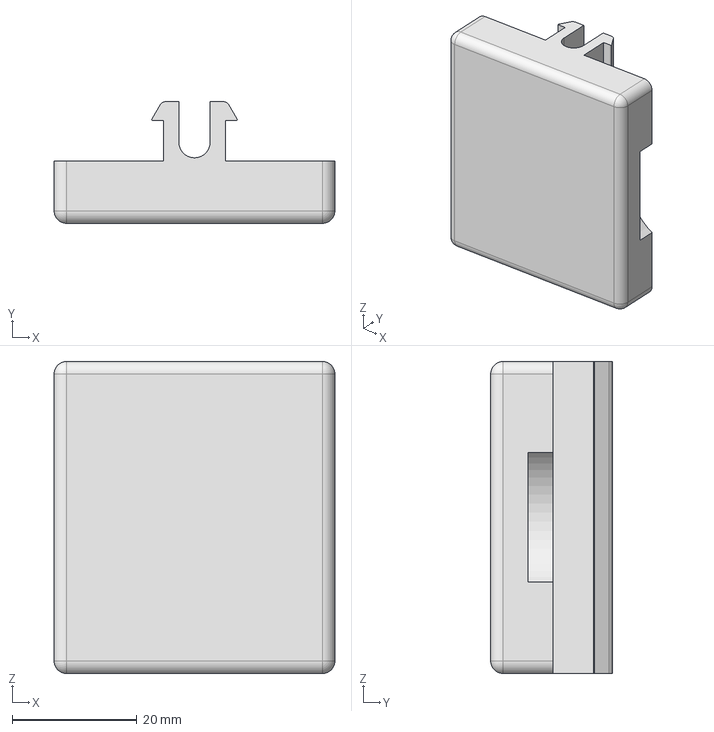
[picture p48: CAD file, 2019-04-08]
CAD/RobotMainFrame/pieces_imprimes/Extrusion45Foot.stp
45.0 x 19.5 x 50.0 mm
