Jason-sketch729/OpenSourcePlanarCableRobot-main/CAD/ElectricalCabinet/backboard.SLDPRT

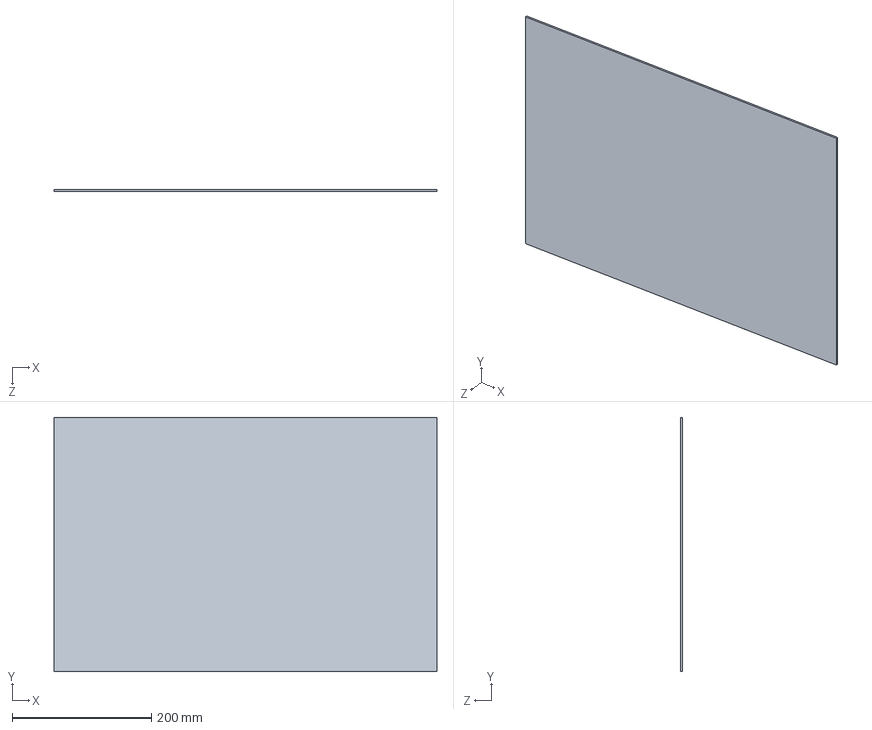
[picture p49: CAD file, 2019-04-02]
CAD/ElectricalCabinet/backboard.SLDPRT
550.0 x 365.0 x 3.00 mm
