Jason-sketch729/OpenSourcePlanarCableRobot-main/CAD/ElectricalCabinet/bouton.SLDPRT

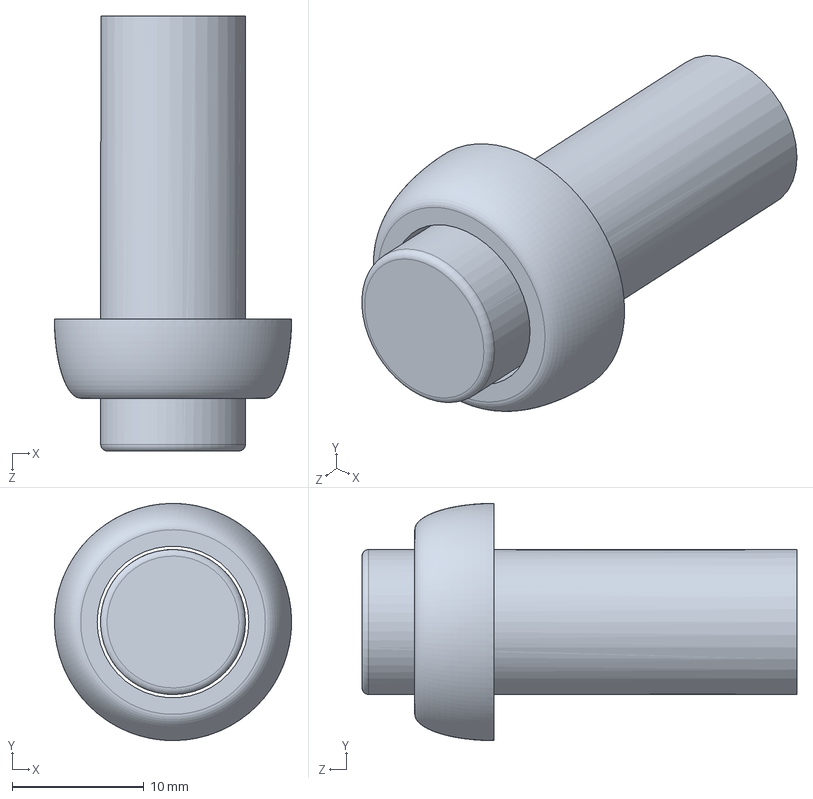
[picture p50: CAD file, 2019-04-02]
CAD/ElectricalCabinet/bouton.SLDPRT
18.0 x 18.0 x 33.0 mm
