Jason-sketch729/OpenSourcePlanarCableRobot-main/CAD/ElectricalCabinet/arduino_mega.SLDPRT

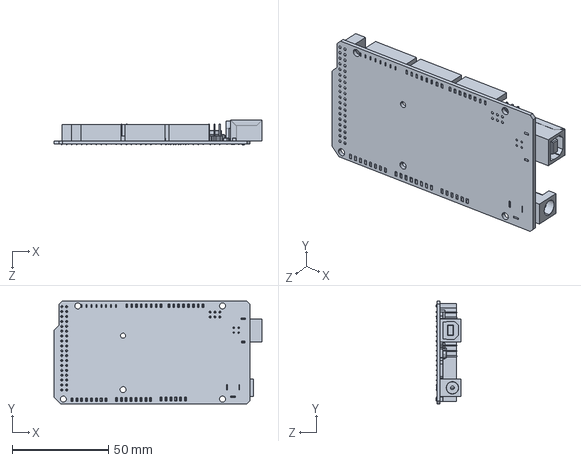
[picture p51: CAD file, 2019-04-02]
CAD/ElectricalCabinet/arduino_mega.SLDPRT
107.9 x 53.4 x 13.0 mm
