Jason-sketch729/OpenSourcePlanarCableRobot-main/CAD/ElectricalCabinet/d-sub-15.SLDPRT

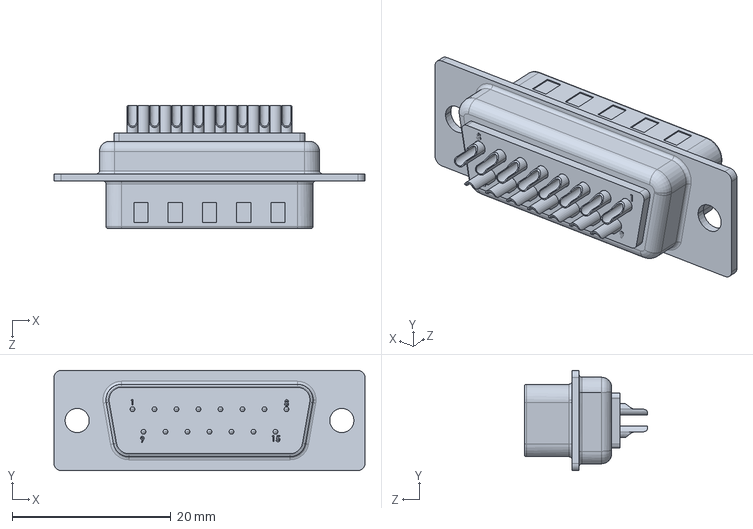
[picture p52: CAD file, 2019-04-02]
CAD/ElectricalCabinet/d-sub-15.SLDPRT
39.2 x 12.6 x 15.5 mm
