Jason-sketch729/OpenSourcePlanarCableRobot-main/(list of files, cad)

Other CAD files:
CAD/SpiralPulley/partA.SLDPRT
CAD/SpiralPulley/partB.SLDPRT
CAD/ElectricalCabinet/standoff_arduino.SLDPRT
CAD/RobotMainFrame/3DPrintedParts/equerre_T_support_milieu_1.STL
CAD/RobotMainFrame/3DPrintedParts/fixation_lumière_0.STL
CAD/RobotMainFrame/pieces_imprimes/equerre_T_support_inferieur.SLDPRT
CAD/RobotMainFrame/pieces_imprimes/support_aimant_plexi.SLDPRT
CAD/RobotMainFrame/pieces_imprimes/equerre_L_support_angle_arriere.SLDPRT
CAD/RobotMainFrame/3DPrintedParts/cale_charnière_0.STL
CAD/RobotMainFrame/pieces_imprimes/support_led.SLDPRT
CAD/RobotMainFrame/pieces_imprimes/equerre_L_support_angle.SLDPRT
CAD/RobotMainFrame/3DPrintedParts/equerre_L_support_angle_8.STL
CAD/RobotMainFrame/pieces_imprimes/equerre_T_support_base.SLDPRT
