Jason-sketch729/OpenSourcePlanarCableRobot-main/Programs/DataAcquisition/ExampleOfCurrentMeasured.csv

2.300262451171875000e-03 -2.989200000004021973e-03 -4.746200000003586439e-03 4.461991999999941338e-01 -4.985159999999955183e-02
5.768537521362304688e-03 1.709499999999541942e-02 1.313899999999845747e-02 4.686289999999917466e-01 -3.416540000000911625e-02
1.411795616149902344e-02 4.626840000000020936e-02 3.556880000000317565e-02 5.000013999999939340e-01 -2.793000000006928829e-03
1.553654670715332031e-02 -4.095860000001261270e-02 2.208159999998882128e-02 4.731735999999944209e-01 -3.196640000000461335e-02
3.055453300476074219e-02 3.952479999999303217e-02 5.785199999999290910e-02 5.089439999999914033e-01 -7.337600000009603107e-03
3.854870796203613281e-02 -5.224680000000825331e-02 -5.840180000000261273e-02 3.992872000000022847e-01 -1.035072000000056835e-01
3.854870796203613281e-02 6.415359999999514784e-02 5.785199999999290910e-02 5.133419999999933037e-01 8.348599999995043319e-03
5.453991889953613281e-02 1.944059999999359079e-02 -5.620280000000521525e-02 4.127743999999953228e-01 -8.562200000000363964e-02
6.253337860107421875e-02 3.058219999999556293e-02 6.239659999999558337e-02 5.022003999999913315e-01 -4.992000000004326310e-03
7.054591178894042969e-02 3.754399999988944359e-03 1.997399999996485320e-03 4.618853999999987803e-01 -3.196640000000461335e-02
7.852053642272949219e-02 2.838319999999816545e-02 3.322319999999079343e-02 4.887131999999982934e-01 -9.536600000007000588e-03
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
0.000000000000000000e+00 0.000000000000000000e+00 0.000000000000000000e+00 0.000000000000000000e+00 0.000000000000000000e+00
0.000000000000000000e+00 0.000000000000000000e+00 0.000000000000000000e+00 0.000000000000000000e+00 0.000000000000000000e+00
0.000000000000000000e+00 0.000000000000000000e+00 0.000000000000000000e+00 0.000000000000000000e+00 0.000000000000000000e+00
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
