Jason-sketch729/OpenSourcePlanarCableRobot-main/Programs/RoboCableMainControl/interp_traj.h

const int N_steps = 50;
float M1_steps[50] = {-1017.0,-1989.0,-2909.0,-3773.0,-4573.0,-5302.0,-5953.0,-6517.0,-6086.0,-4987.0,-3680.0,-2198.0,-570.0,1177.0,3023.0,4951.0,5997.0,5194.0,4440.0,3738.0,3092.0,2505.0,1982.0,1525.0,1138.0,1982.0,3092.0,4440.0,5997.0,7734.0,9625.0,11648.0,13783.0,13783.0,12703.0,11648.0,10622.0,9625.0,8662.0,7734.0,6844.0,6007.0,5213.0,4430.0,3658.0,2898.0,2151.0,1418.0,701.0,0.0};
float M2_steps[50] = {-1017.0,-1989.0,-2909.0,-3773.0,-4573.0,-5302.0,-5953.0,-6517.0,-6086.0,-4987.0,-3680.0,-2198.0,-570.0,1177.0,3023.0,4951.0,6557.0,7433.0,8348.0,9300.0,10286.0,11303.0,12349.0,13421.0,14517.0,12349.0,10286.0,8348.0,6557.0,4937.0,3516.0,2324.0,1388.0,1388.0,1822.0,2324.0,2890.0,3516.0,4200.0,4937.0,5724.0,6007.0,5213.0,4430.0,3658.0,2898.0,2151.0,1418.0,701.0,0.0};
float M3_steps[50] = {1057.0,2151.0,3276.0,4430.0,5609.0,6811.0,8034.0,9275.0,8308.0,6274.0,4300.0,2398.0,583.0,-1127.0,-2709.0,-4137.0,-5411.0,-6665.0,-7889.0,-9075.0,-10215.0,-11300.0,-12318.0,-13251.0,-14083.0,-12318.0,-10215.0,-7889.0,-5411.0,-2829.0,-174.0,2535.0,5284.0,5284.0,3905.0,2535.0,1175.0,-174.0,-1510.0,-2829.0,-4131.0,-4824.0,-4314.0,-3773.0,-3204.0,-2608.0,-1989.0,-1346.0,-683.0,0.0};
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
*/
