Jason-sketch729/OpenSourcePlanarCableRobot-main/Programs/RoboCableMainControl/interp_traj2.h

const int N_steps = 50;
float M1_steps[50] = {-1286.0,-2339.0,-3358.0,-4341.0,-5287.0,-6202.0,-7095.0,-7996.0,-7293.0,-5799.0,-4233.0,-2569.0,-808.0,973.0,2798.0,4684.0,5698.0,4920.0,4186.0,3500.0,2866.0,2288.0,1655.0,1005.0,336.0,1655.0,2866.0,4186.0,5698.0,7369.0,9171.0,11079.0,13069.0,13069.0,12065.0,11079.0,10113.0,9171.0,8256.0,7369.0,6493.0,5708.0,4939.0,4176.0,3421.0,2675.0,1938.0,1212.0,499.0,-202.0};
float M2_steps[50] = {-1368.0,-2422.0,-3441.0,-4424.0,-5372.0,-6286.0,-7180.0,-8082.0,-7379.0,-5883.0,-4317.0,-2651.0,-890.0,892.0,2718.0,4604.0,6145.0,6991.0,7879.0,8786.0,9720.0,10678.0,11658.0,12657.0,13673.0,11658.0,9720.0,7879.0,6145.0,4591.0,3203.0,2013.0,705.0,705.0,1357.0,2013.0,2586.0,3203.0,3872.0,4591.0,5355.0,5629.0,4860.0,4097.0,3341.0,2594.0,1857.0,1131.0,417.0,-283.0};
float M3_steps[50] = {854.0,1938.0,3047.0,4176.0,5323.0,6484.0,7657.0,8839.0,7919.0,5966.0,4050.0,2182.0,381.0,-1405.0,-3135.0,-4766.0,-6275.0,-7620.0,-8922.0,-10198.0,-11424.0,-12591.0,-13790.0,-14984.0,-16165.0,-13790.0,-11424.0,-8922.0,-6275.0,-3472.0,-603.0,2317.0,5007.0,5007.0,3664.0,2317.0,857.0,-603.0,-2047.0,-3472.0,-4887.0,-5595.0,-4976.0,-4341.0,-3690.0,-3022.0,-2339.0,-1641.0,-928.0,-202.0};
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
*/
