Jason-sketch729/OpenSourcePlanarCableRobot-main/Programs/RoboCableMainControl/traj.h

int32_t Traj2[][4] = {  {-1017.0,-1017.0,1057.0,1057.0},
						{-1989.0,-1989.0,2151.0,2151.0},
						{-2909.0,-2909.0,3276.0,3276.0},
						{-3773.0,-3773.0,4430.0,4430.0},
						{-4573.0,-4573.0,5609.0,5609.0},
						{-5302.0,-5302.0,6811.0,6811.0},
						{-5953.0,-5953.0,8034.0,8034.0},
						{-6517.0,-6517.0,9275.0,9275.0},
						{-6086.0,-6086.0,8308.0,8308.0},
						{-4987.0,-4987.0,6274.0,6274.0},
						{-3680.0,-3680.0,4300.0,4300.0},
						{-2198.0,-2198.0,2398.0,2398.0},
						{-570.0,-570.0,583.0,583.0},
						{1177.0,1177.0,-1127.0,-1127.0},
						{3023.0,3023.0,-2709.0,-2709.0},
						{4951.0,4951.0,-4137.0,-4137.0},
						{5997.0,6557.0,-5411.0,-4560.0},
						{5194.0,7433.0,-6665.0,-3266.0},
						{4440.0,8348.0,-7889.0,-1951.0},
						{3738.0,9300.0,-9075.0,-621.0},
						{3092.0,10286.0,-10215.0,724.0},
						{2505.0,11303.0,-11300.0,2080.0},
						{1982.0,12349.0,-12318.0,3447.0},
						{1525.0,13421.0,-13251.0,4824.0},
						{1138.0,14517.0,-14083.0,6208.0},
						{1982.0,12349.0,-12318.0,3447.0},
						{3092.0,10286.0,-10215.0,724.0},
						{4440.0,8348.0,-7889.0,-1951.0},
						{5997.0,6557.0,-5411.0,-4560.0},
						{7734.0,4937.0,-2829.0,-7077.0},
						{9625.0,3516.0,-174.0,-9461.0},
						{11648.0,2324.0,2535.0,-11648.0},
						{13783.0,1388.0,5284.0,-13541.0},
						{13783.0,1388.0,5284.0,-13541.0},
						{12703.0,1822.0,3905.0,-12639.0},
						{11648.0,2324.0,2535.0,-11648.0},
						{10622.0,2890.0,1175.0,-10584.0},
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
						{3000.0,1206.0,3831.0,2506.0},
						{2931.0,1394.0,3806.0,2753.0},
						{2850.0,1572.0,3778.0,2956.0},
						{2769.0,1739.0,3747.0,3119.0},
						{2675.0,1900.0,3711.0,3256.0},
						{2578.0,2047.0,3664.0,3367.0},
						{2472.0,2186.0,3617.0,3458.0},
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

int Traj2Fin=50;
