Jason-sketch729/OpenSourcePlanarCableRobot-main/Programs/RoboCableMainControl/traj2.h

int32_t Traj2[][4] = {  {-1286.0,-1368.0,854.0,854.0},
						{-2339.0,-2422.0,1938.0,1938.0},
						{-3358.0,-3441.0,3047.0,3047.0},
						{-4341.0,-4424.0,4176.0,4176.0},
						{-5287.0,-5372.0,5323.0,5323.0},
						{-6202.0,-6286.0,6484.0,6484.0},
						{-7095.0,-7180.0,7657.0,7657.0},
						{-7996.0,-8082.0,8839.0,8839.0},
						{-7293.0,-7379.0,7919.0,7919.0},
						{-5799.0,-5883.0,5966.0,5966.0},
						{-4233.0,-4317.0,4050.0,4050.0},
						{-2569.0,-2651.0,2182.0,2182.0},
						{-808.0,-890.0,381.0,381.0},
						{973.0,892.0,-1405.0,-1405.0},
						{2798.0,2718.0,-3135.0,-3135.0},
						{4684.0,4604.0,-4766.0,-4766.0},
						{5698.0,6145.0,-6275.0,-5347.0},
						{4920.0,6991.0,-7620.0,-3948.0},
						{4186.0,7879.0,-8922.0,-2524.0},
						{3500.0,8786.0,-10198.0,-1086.0},
						{2866.0,9720.0,-11424.0,369.0},
						{2288.0,10678.0,-12591.0,1839.0},
						{1655.0,11658.0,-13790.0,3215.0},
						{1005.0,12657.0,-14984.0,4560.0},
						{336.0,13673.0,-16165.0,5902.0},
						{1655.0,11658.0,-13790.0,3215.0},
						{2866.0,9720.0,-11424.0,369.0},
						{4186.0,7879.0,-8922.0,-2524.0},
						{5698.0,6145.0,-6275.0,-5347.0},
						{7369.0,4591.0,-3472.0,-8049.0},
						{9171.0,3203.0,-603.0,-10613.0},
						{11079.0,2013.0,2317.0,-12978.0},
						{13069.0,705.0,5007.0,-15377.0},
						{13069.0,705.0,5007.0,-15377.0},
						{12065.0,1357.0,3664.0,-14191.0},
						{11079.0,2013.0,2317.0,-12978.0},
						{10113.0,2586.0,857.0,-11821.0},
						{9171.0,3203.0,-603.0,-10613.0},
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
						{2789.0,1811.0,3731.0,3294.0},
						{2739.0,1822.0,3742.0,3369.0},
						{2683.0,1592.0,4056.0,3214.0},
						{2617.0,1714.0,4056.0,3356.0},
						{2542.0,1858.0,4011.0,3503.0},
						{2464.0,1997.0,3958.0,3619.0},
						{2433.0,2122.0,3931.0,3644.0},
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

int Traj2Fin=50;
