Jason-sketch729/OpenSourcePlanarCableRobot-main/(commit log)

2019-04-02 Add part 1 of 9
    [BOM.xlsx, DB9_pins.SLDPRT, ElectricalCabinet.SLDASM, Mean Well LRS-350 Power Supply.SLDPRT, arduino_mega.SLDPRT, backboard.SLDPRT, bonier_4.SLDPRT, bonier_6.SLDPRT]
2019-04-03 Add part 2 of 9
    [Extrusion45Foot v2_4.STL, cale_charnière_0.STL, equerre_L_support_angle_8.STL, equerre_L_support_angle_arriere_0.STL, equerre_L_support_angle_sym_8.STL, mega_shield.SLDPRT, roboclaw.SLDPRT, round_switch.SLDPRT]
2019-04-07 Add part 3 of 9
    [ActuationUnit.SLDASM, CableRobotMainFrame.SLDASM, barre_alu.SLDPRT, demi_charnière_porte_3.5in.SLDPRT, equerre_T_support_base_2.STL, equerre_T_support_inferieur_4.STL, equerre_T_support_milieu_1.STL, extrusion_alu_45_1000.SLDPRT]
2019-04-08 Add part 4 of 9
    [Extrusion45Foot v2.SLDPRT, Extrusion45Foot.stp, coupleur_poulie-moteur.SLDPRT, extrusion_alu_45_1045.SLDPRT, extrusion_alu_45_1415.SLDPRT, extrusion_alu_45_325.SLDPRT, extrusion_alu_45_720.SLDPRT, moteur.SLDPRT]
2019-04-15 Add part 5 of 9
    [cale_charnière.SLDPRT, equerre_L_support_angle.SLDPRT, equerre_L_support_angle_arriere.SLDPRT, equerre_L_support_angle_sym.SLDPRT, equerre_T_support_base.SLDPRT, equerre_T_support_inferieur.SLDPRT, equerre_T_support_milieu.SLDPRT, fixation_lumière.SLDPRT]
2019-04-16 Add part 6 of 9
    [Assembly.SLDASM, NewSpool2PartA.stp, NewSpool2PartB.stp, partA.SLDPRT, partA.STL, partB.SLDPRT, partB.STL, plexi-protection.SLDPRT]
2019-04-18 Add part 7 of 9
    [ExampleOfCurrentMeasured.csv]
2019-04-22 Add part 9 of 9
    [RobotcableComplet.stp]
